qnhuw08/test2/Module_Relay_RS485/Production/Schematic PDF/Module_Relay_RS485.pdf

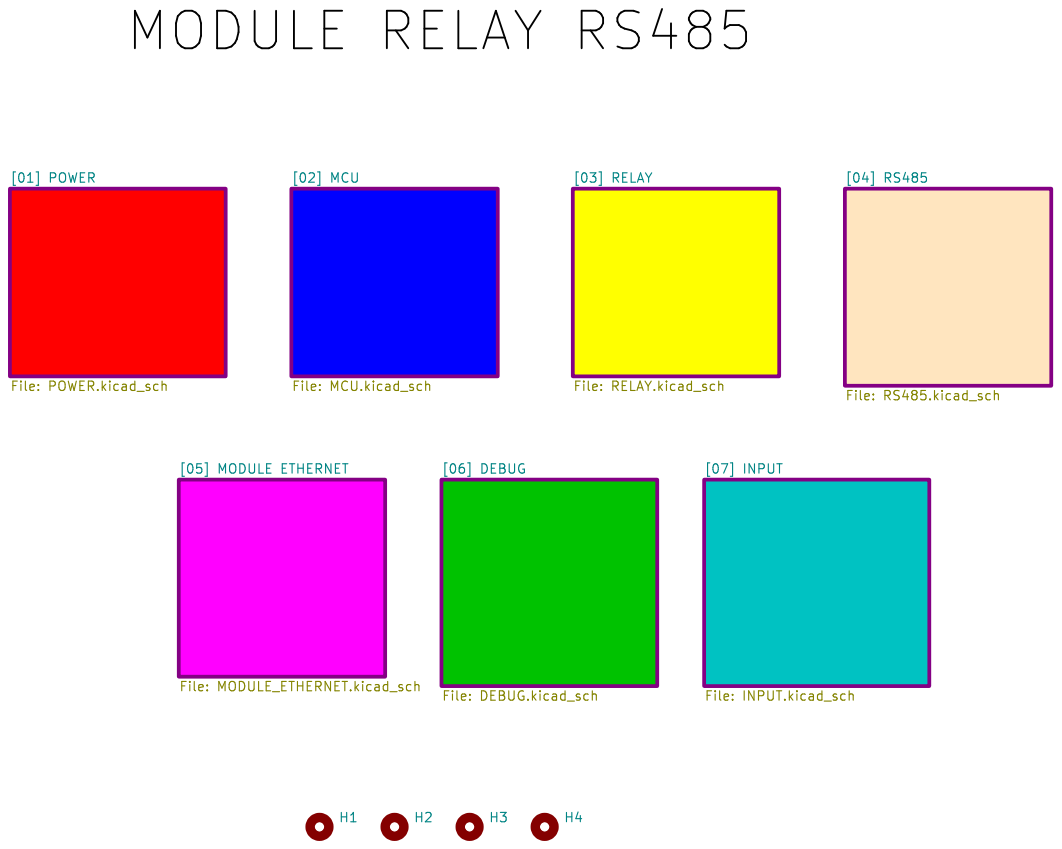
[picture p1: page 1]

Id: 1/8 Title: File: Module_Relay_RS485.kicad_sch Sheet: /

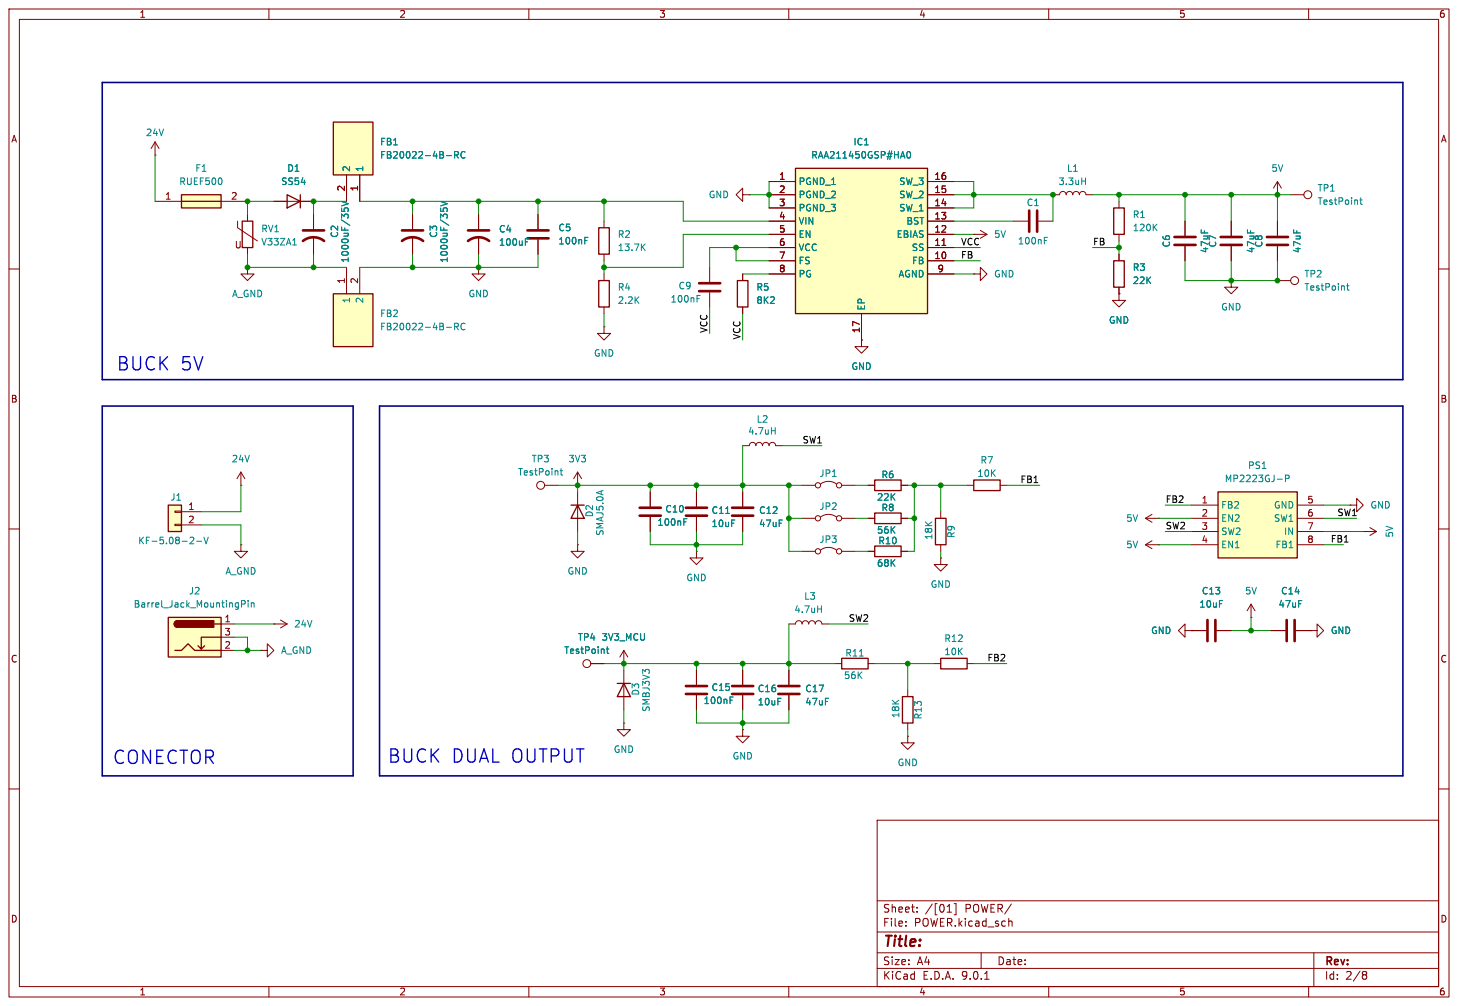
[picture p2: page 2]

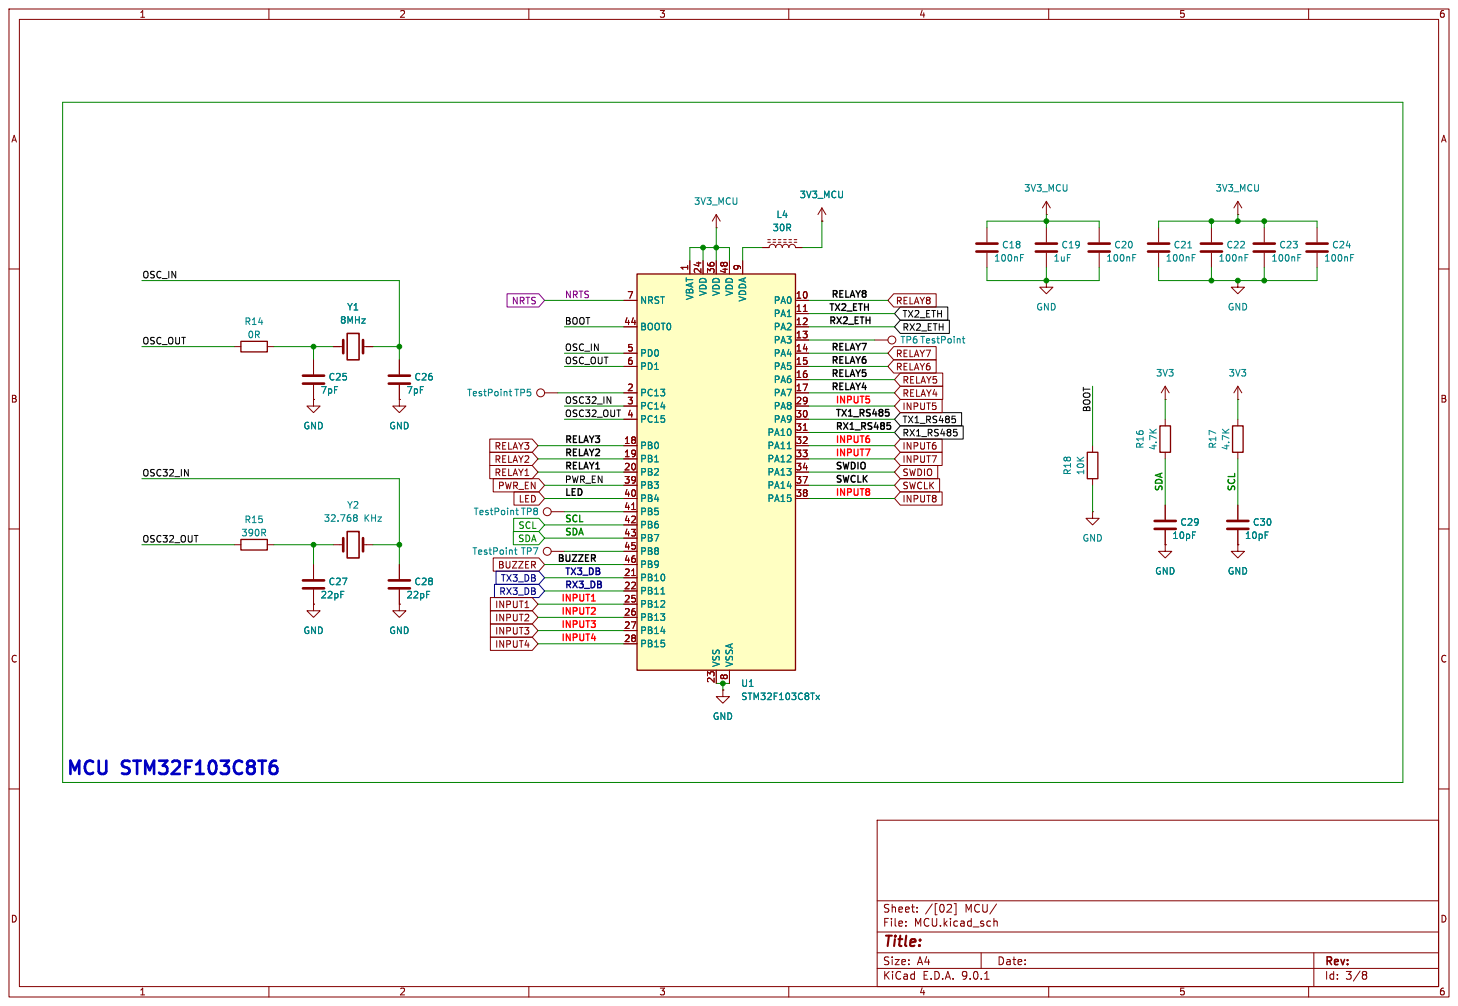
[picture p3: page 3]

1 VDD 24 VDD 36 VSS 23 VDD 48 VSSA

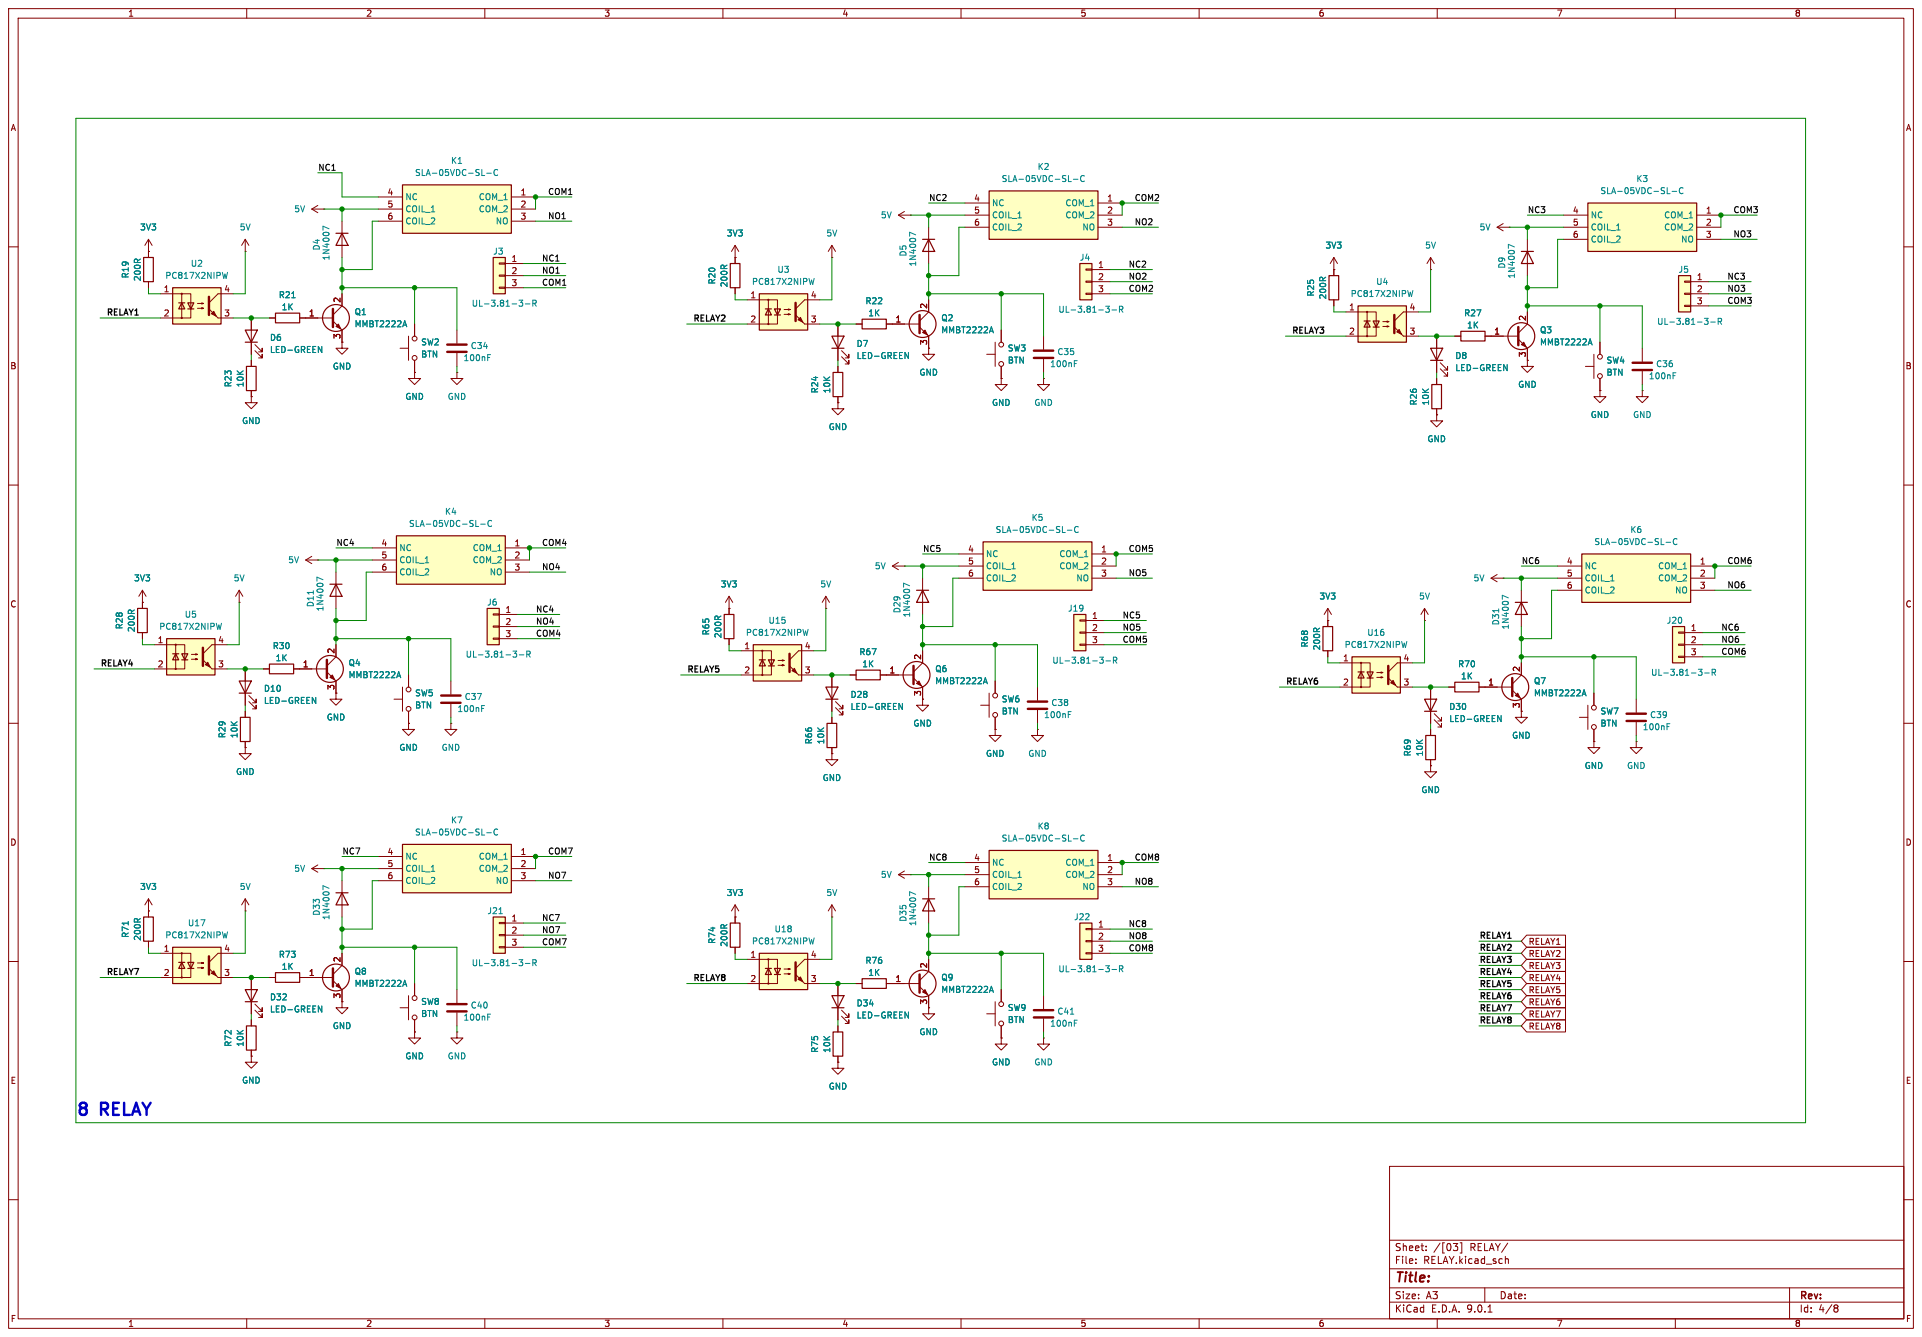
[picture p4: page 4]

2 3 Q2 MMBT2222A COM_1 1 COM_2 2 NO 3 NC 4 COIL_1 5 COIL_2 6 K5 SLA-05VDC-SL-C

2 3 Q8 MMBT2222A COM_1 1 COM_2 2 NO 3 NC 4 COIL_1 5 COIL_2 6 K7 SLA-05VDC-SL-C

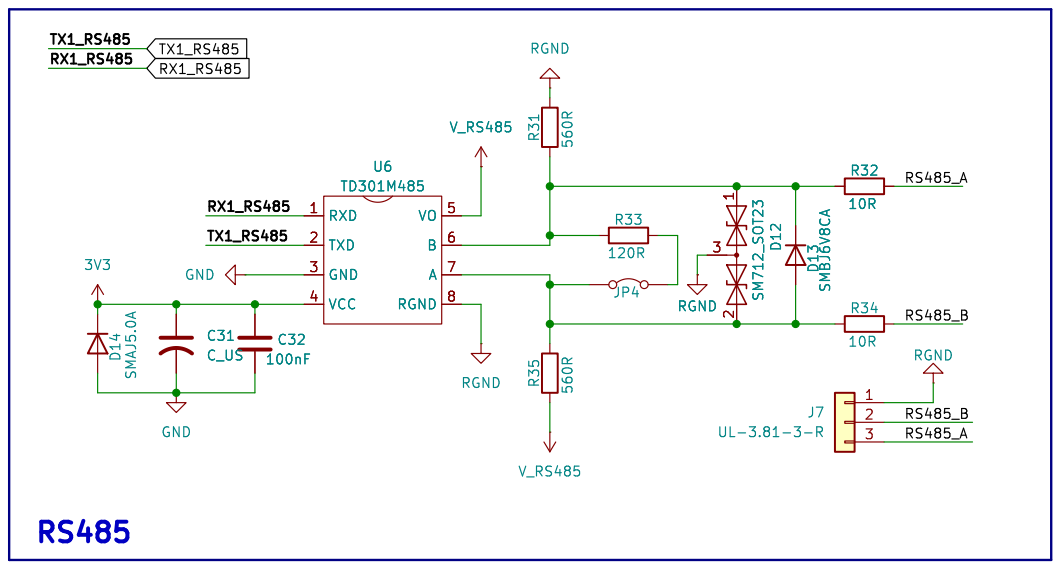
[picture p5: page 5]

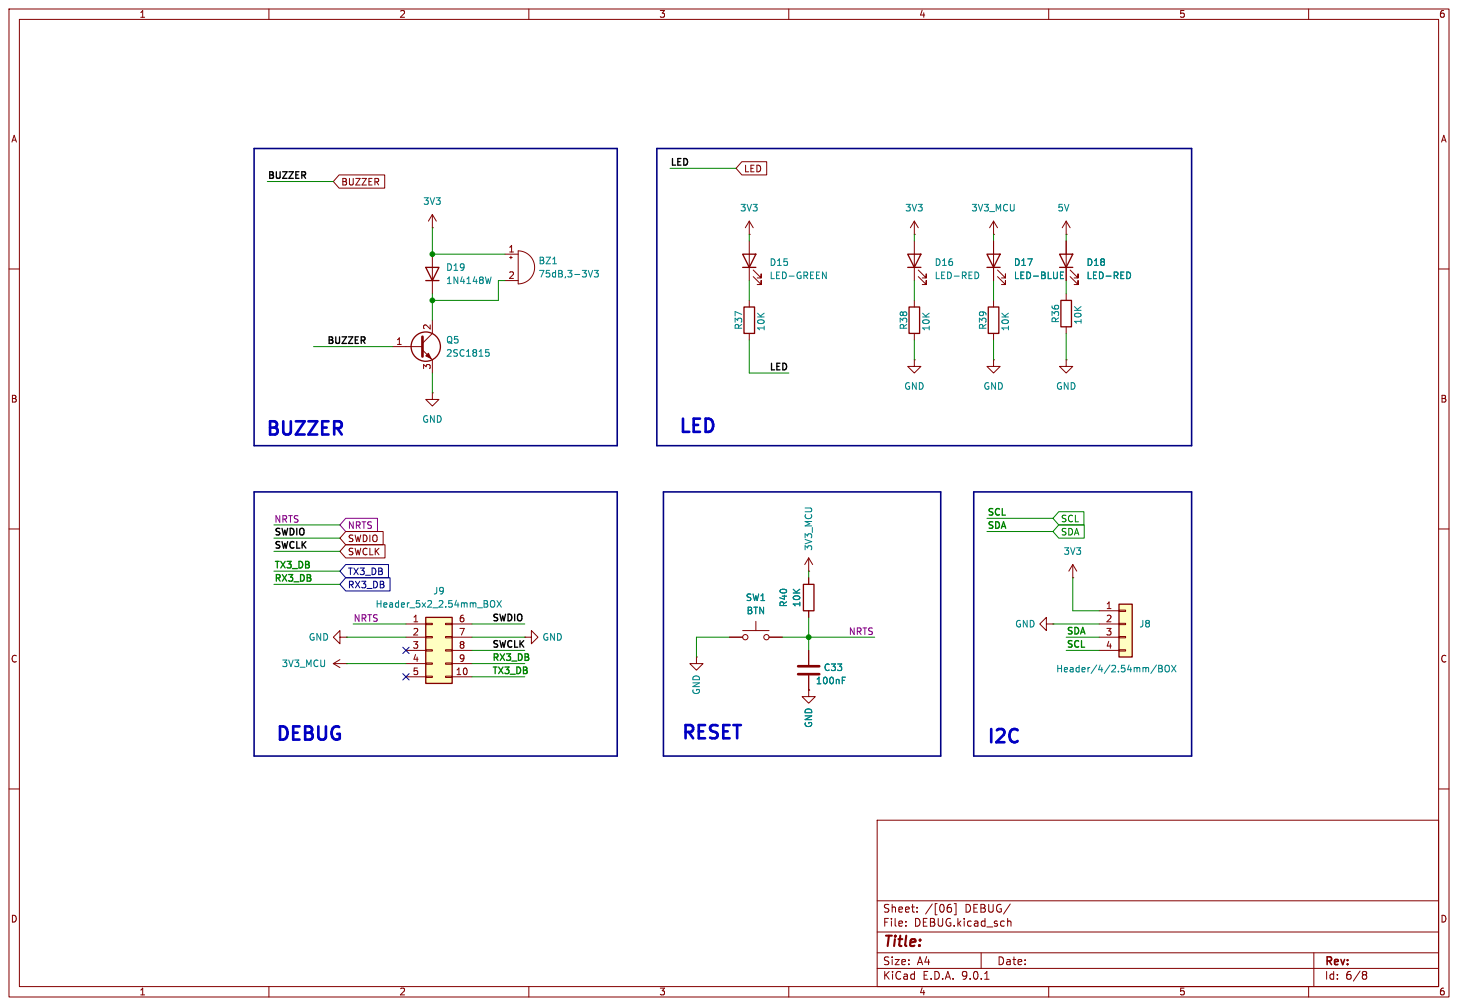
[picture p6: page 6]

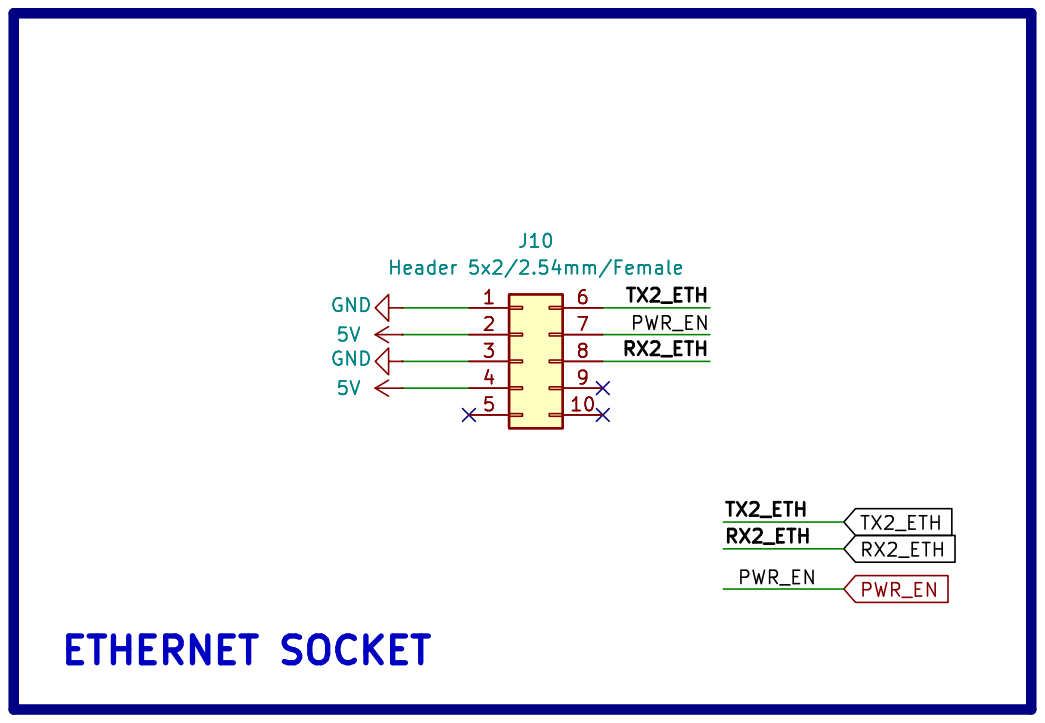
[picture p7: page 7]

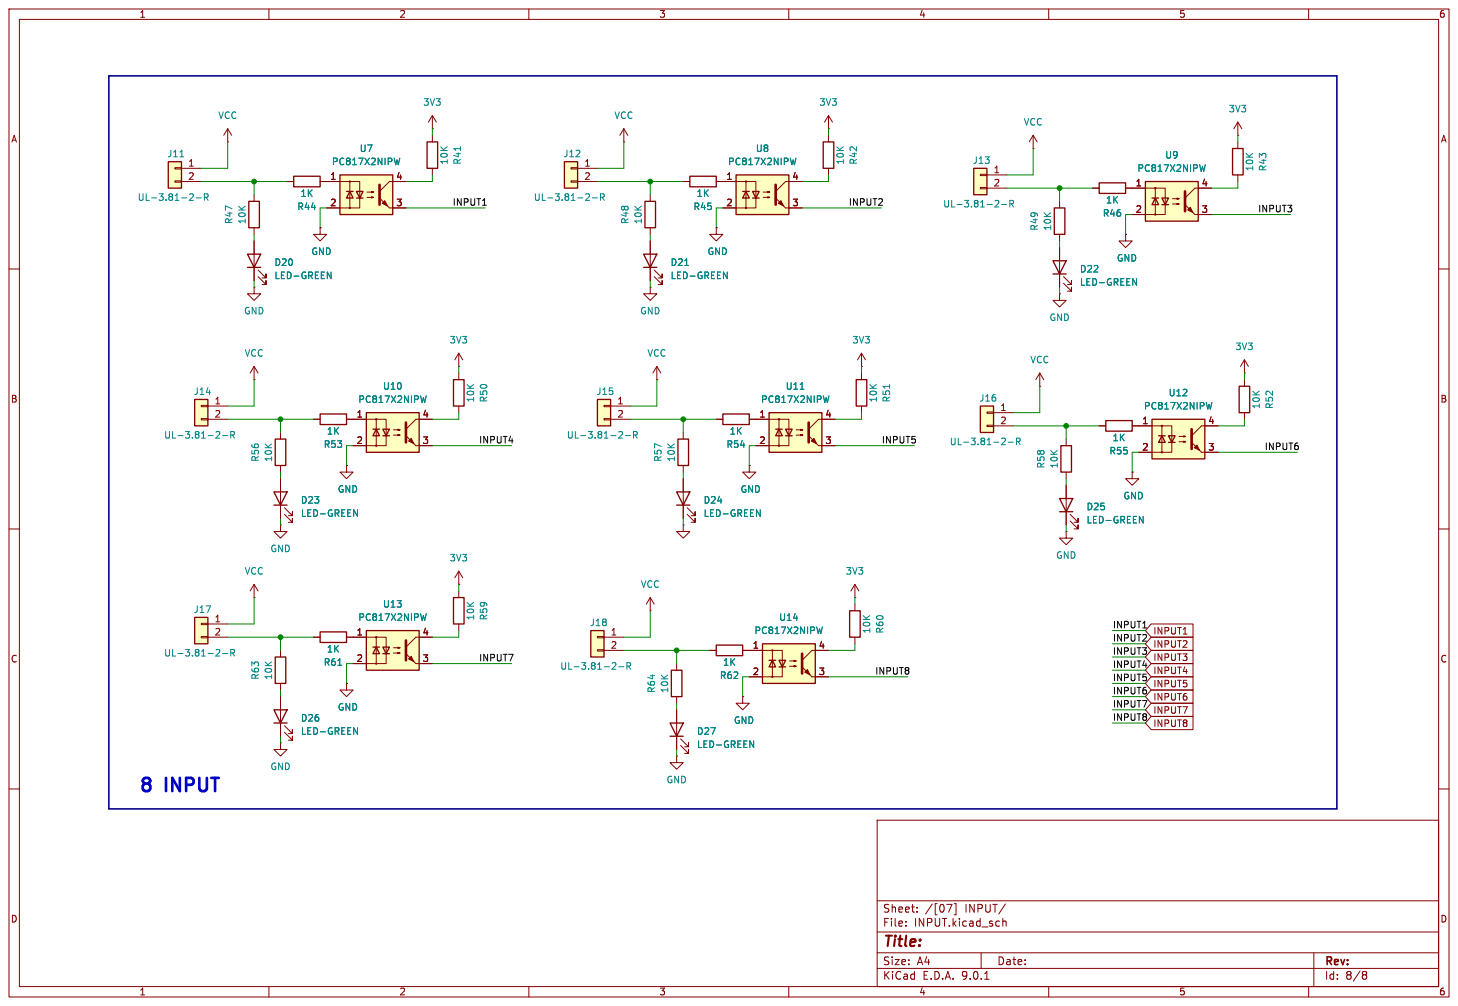
[picture p8: page 8]
