qnhuw08/test2/Module_Relay_RS485/Production/PCB PDF/Module_Relay_RS485-B_Cu.pdf

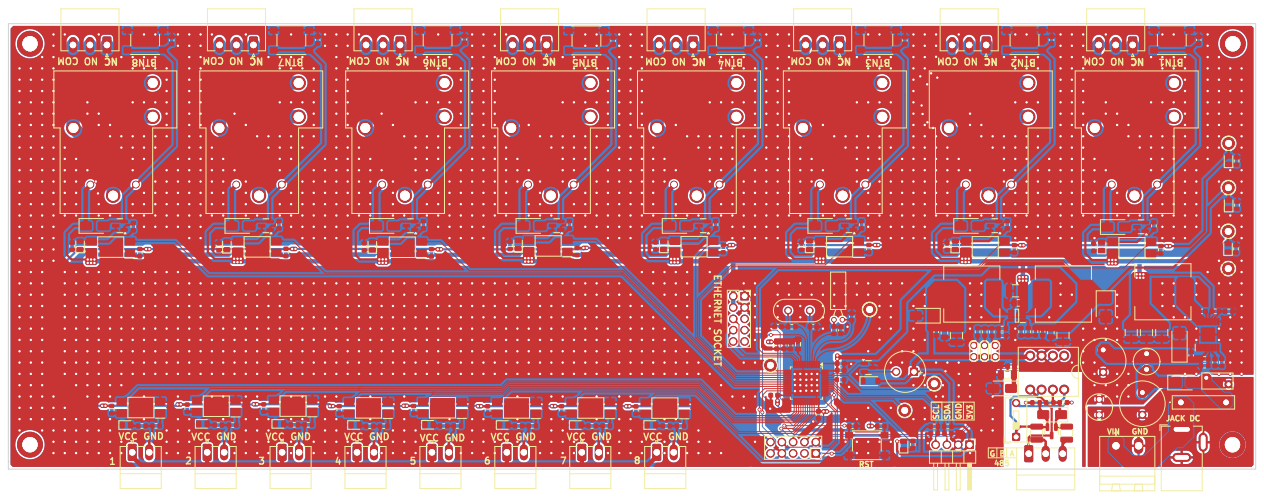
[picture p9: page 1]
