qnhuw08/test2/Module_Relay_RS485/Production/PCB PDF/Module_Relay_RS485-B_Silkscreen.pdf

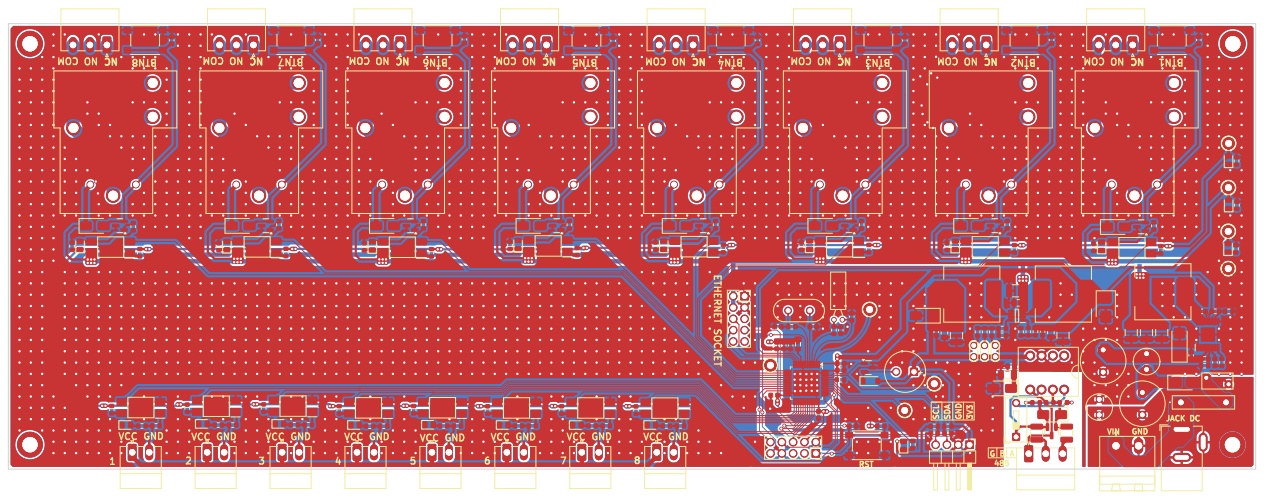
[picture p10: page 1]
