qnhuw08/test2/Module_Relay_RS485/Production/PCB PDF/Module_Relay_RS485-Edge_Cuts.pdf

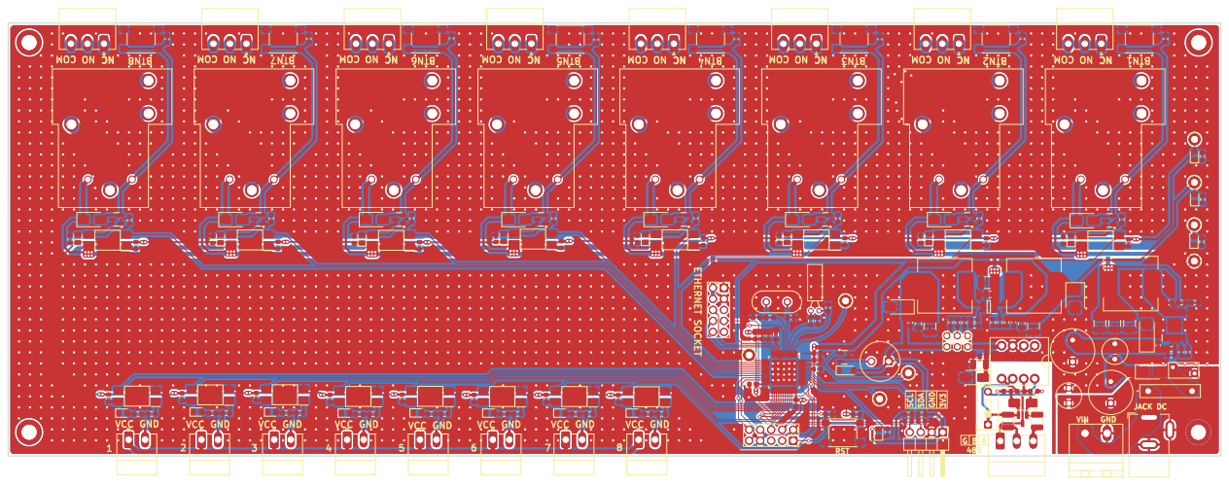
[picture p11: page 1]
