qnhuw08/test2/Module_Relay_RS485/Production/PCB PDF/Module_Relay_RS485-F_Cu.pdf

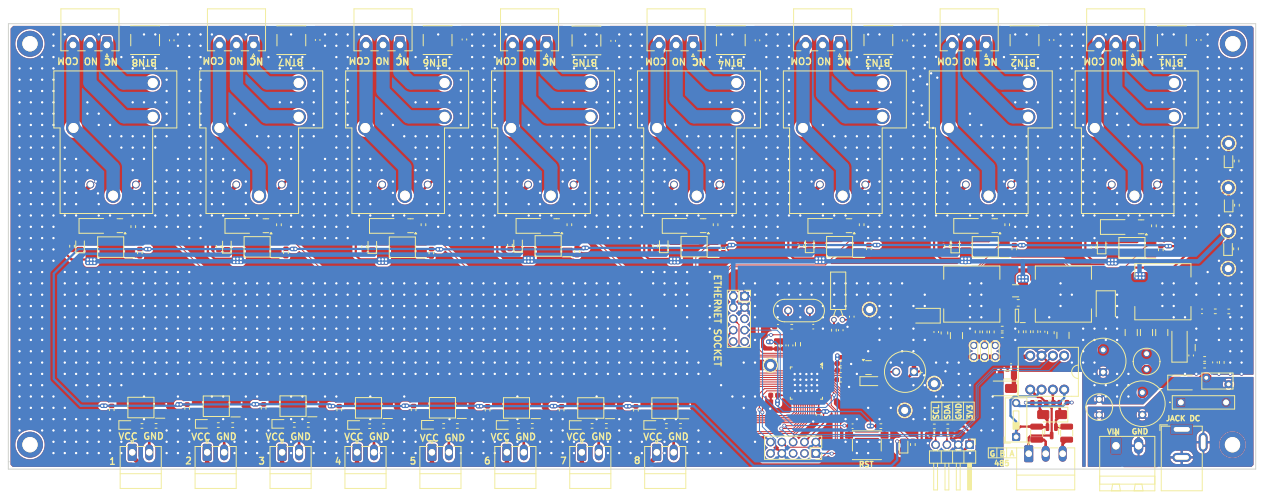
[picture p12: page 1]
