qnhuw08/test2/Module_Relay_RS485/Production/PCB PDF/Module_Relay_RS485-F_Silkscreen.pdf

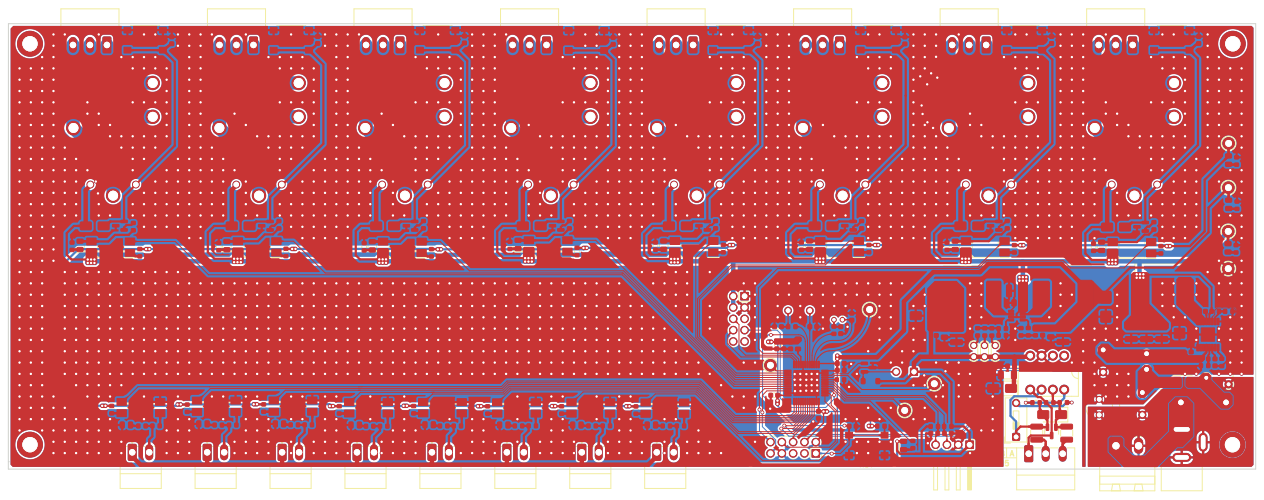
[picture p13: page 1]
