qnhuw08/test2/Module_Relay_RS485/Module_Relay_RS485.kicad_pcb

## KiCad design Module_Relay_RS485/Module_Relay_RS485.kicad_pcb (2026-03-02)

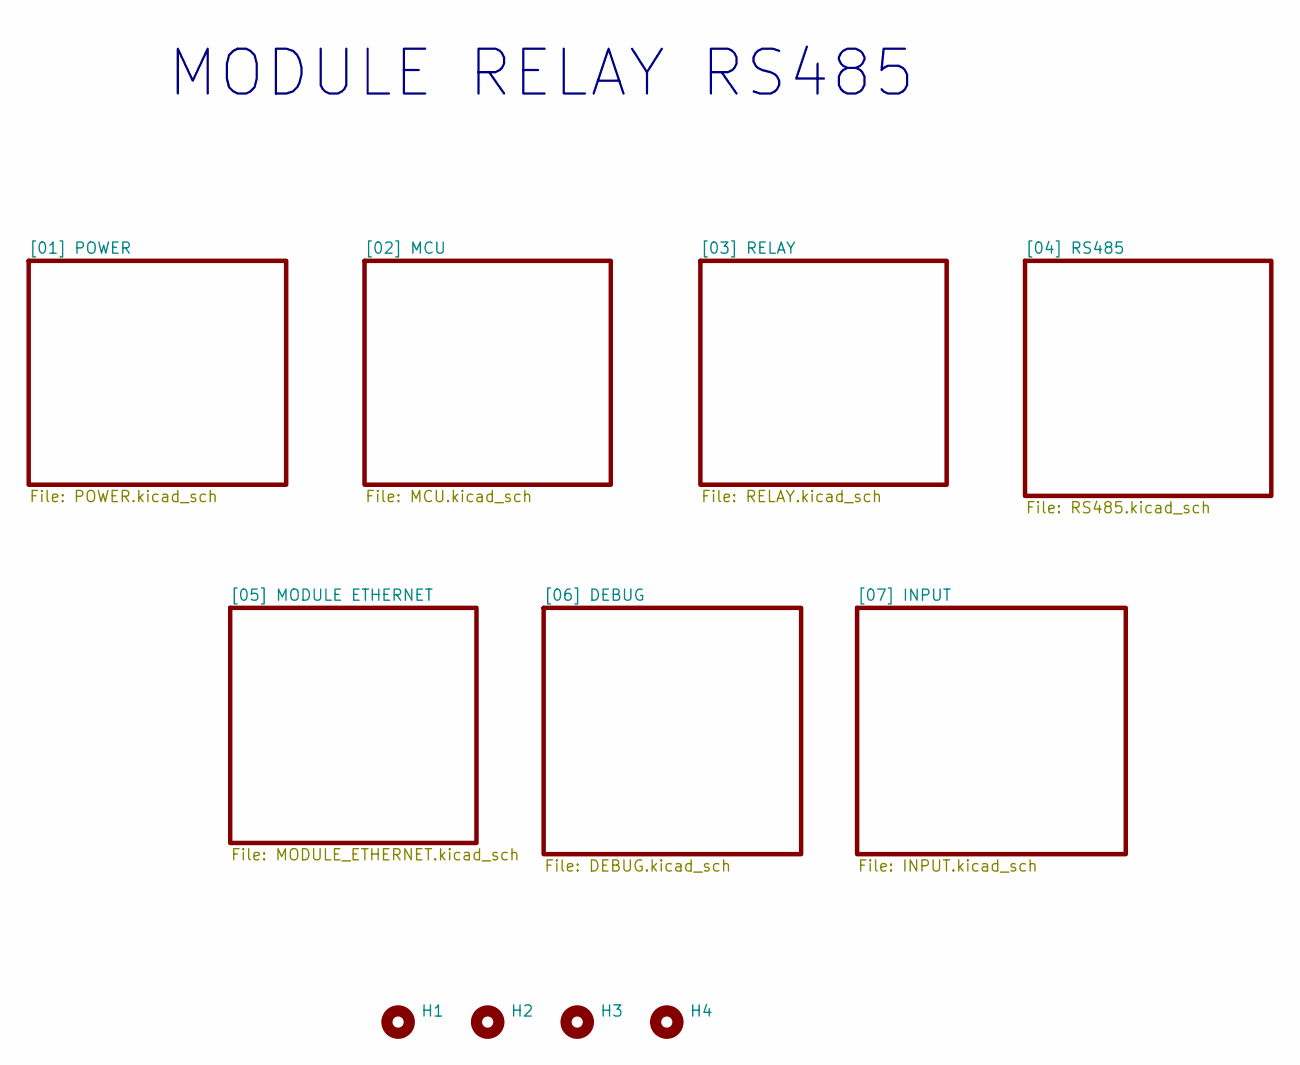
[picture p14: schematic Module_Relay_RS485.kicad_sch]

Parts:
H1, H2, H3, H4: MountingHole; MountingHole_3.2mm_M3_DIN965_Pad

Notes on the sheet:
MODULE RELAY RS485

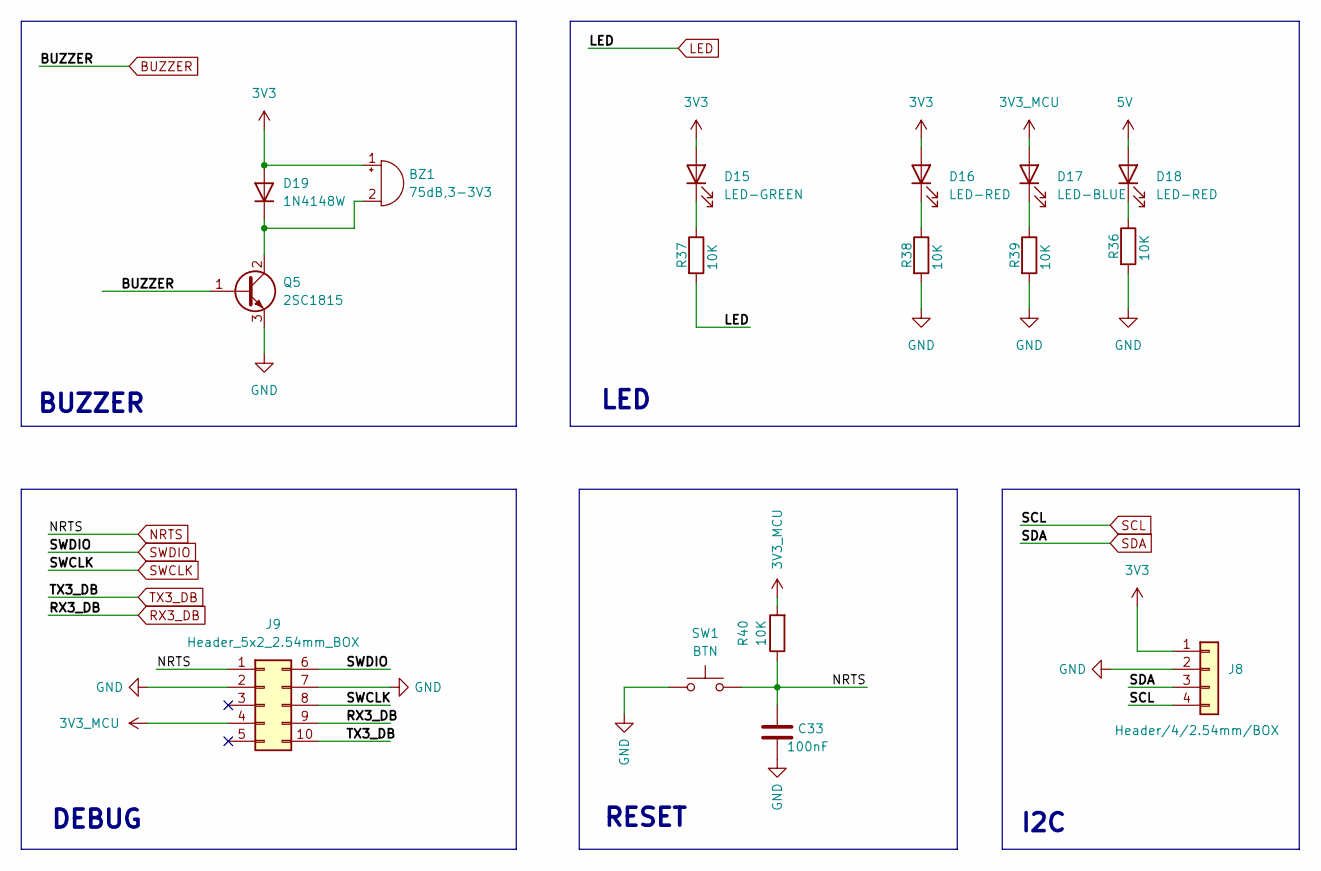
[picture p15: schematic DEBUG.kicad_sch]

Parts:
BZ1: 75dB,3-3V3; MagneticBuzzer_PUI_AT-0927-TT-6-R
C33: 100nF; C_0603_1608Metric
D15: LED-GREEN; LED_0805_2012Metric
D16, D18: LED-RED; LED_0805_2012Metric
D17: LED-BLUE; LED_0805_2012Metric
D19: 1N4148W; D_SOD-123
J8: Header/4/2.54mm/BOX; PinHeader_1x04_P2.54mm_Horizontal
J9: Header_5x2_2.54mm_BOX; Header_2x5_2.54mm_BOX
Q5: 2SC1815; SOT-23
R36, R37, R38, R39, R40: 10K; R_0603_1608Metric
SW1: BTN; SW_SPST_PTS645

Connections:
3V3: BZ1.1 (+), D15.2 (A), D16.2 (A), D19.2 (A), J8.1; also elsewhere on the board
3V3_MCU: D17.2 (A), J9.4, R40.2; also elsewhere on the board
5V: D18.2 (A); also elsewhere on the board
BUZZER: Q5.1 (B); also elsewhere on the board
GND: C33.2, J8.2, J9.2, J9.7, Q5.3 (E), R36.2, R38.2, R39.2, SW1.1; also elsewhere on the board
LED: R37.2; also elsewhere on the board
NRTS: C33.1, J9.1, R40.1, SW1.2; also elsewhere on the board
unnamed: BZ1.2 (-), D19.1 (K), Q5.2 (C)
unnamed: D15.1 (K), R37.1
unnamed: D16.1 (K), R38.1
unnamed: D17.1 (K), R39.1
unnamed: D18.1 (K), R36.1
RX3_DB: J9.9; also elsewhere on the board
SCL: J8.4; also elsewhere on the board
SDA: J8.3; also elsewhere on the board
SWCLK: J9.8; also elsewhere on the board
SWDIO: J9.6; also elsewhere on the board
TX3_DB: J9.10; also elsewhere on the board

Notes on the sheet:
I2C
LED
BUZZER
DEBUG
RESET

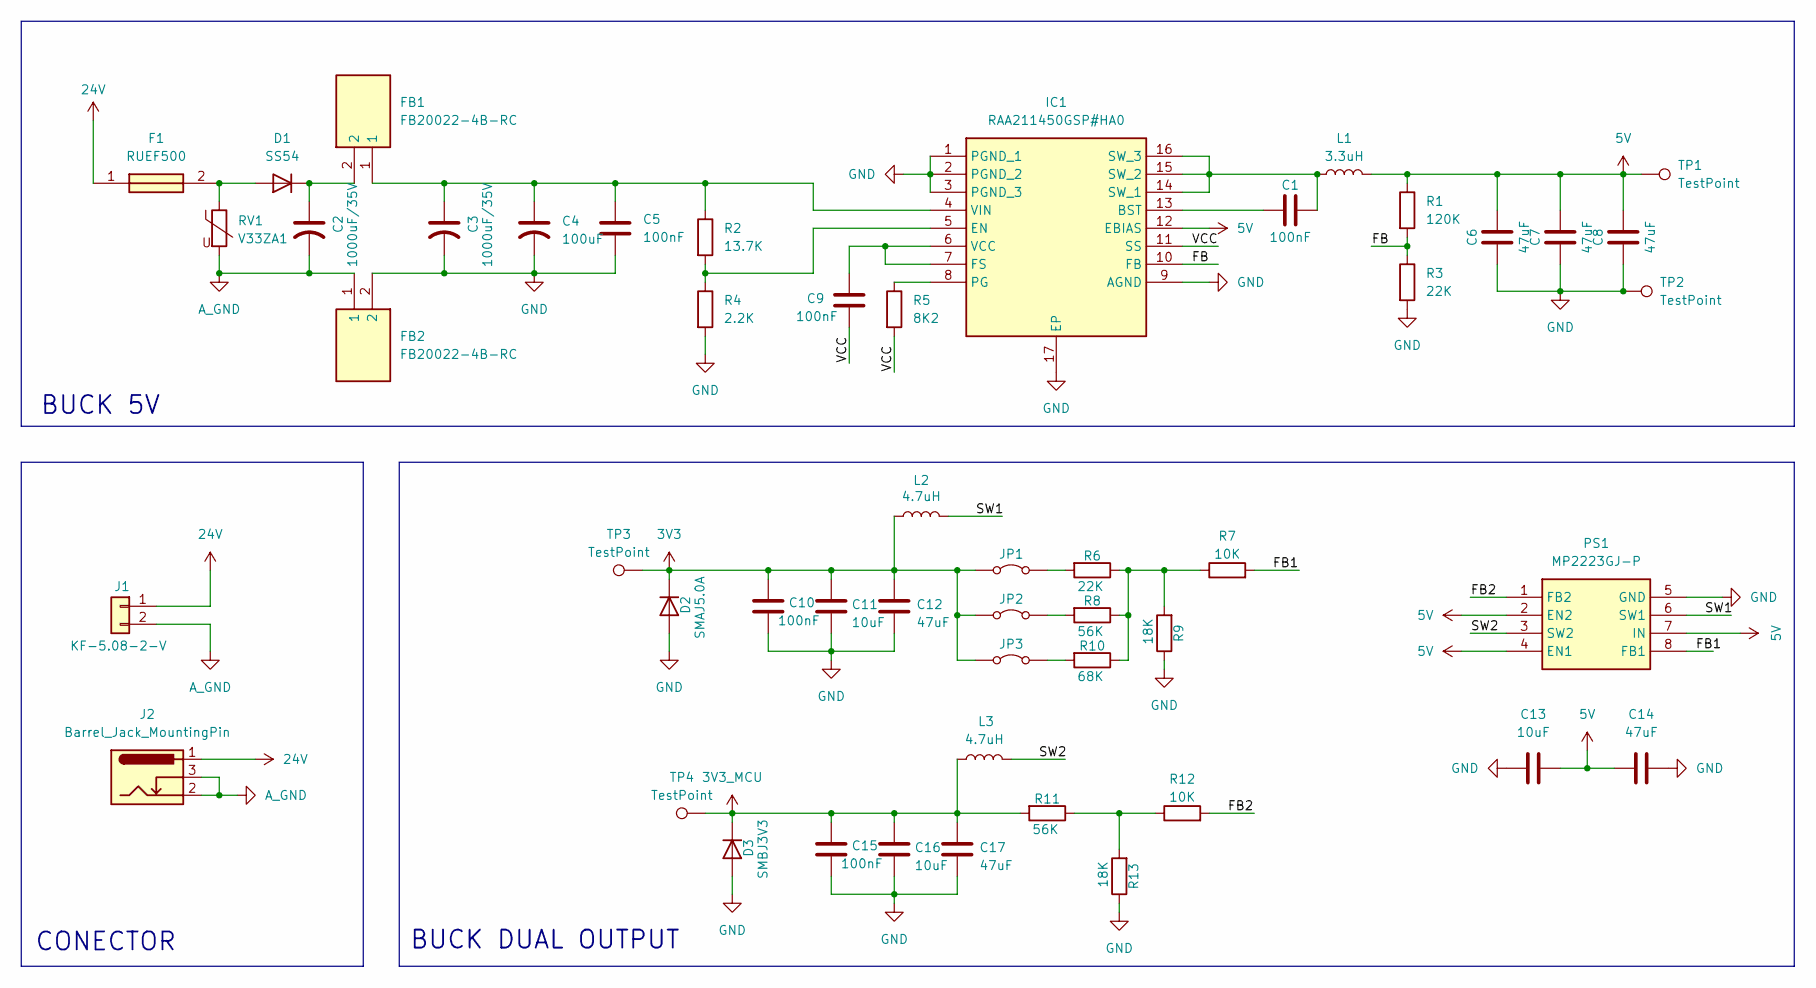
[picture p16: schematic POWER.kicad_sch]

Parts:
C1, C5, C9, C10, C15: 100nF; C_0603_1608Metric
C2, C3: 1000uF/35V; C_Radial_D10.0mm_H20.0mm_P5.00mm
C4: 100uF; CP_EIA-6032-15_Kemet-U_HandSolder
C6, C7, C8, C12, C14, C17: 47uF; C_1210_3225Metric
C11, C13, C16: 10uF; C_0805_2012Metric
D1: SS54; D_SMA
D2: SMAJ5.0A; D_SMA
D3: SMBJ3V3; D_SMB
F1: RUEF500; Manufacturer_Part_Number RUEF500
FB1, FB2: FB20022-4B-RC; FB200224BRC; Manufacturer_Part_Number FB20022-4B-RC; Mouser Part Number 542-FB20022-4B-RC
IC1: RAA211450GSP#HA0; SOP65P640X120-17N; Manufacturer_Part_Number RAA211450GSP#HA0; Mouser Part Number 968-RAA211450GSP#HA0
J1: KF-5.08-2-V; PhoenixContact_MSTBA_2,5_2-G-5,08_1x02_P5.08mm_Horizontal
J2: Barrel_Jack_MountingPin; BarrelJack_GCT_DCJ200-10-A_Horizontal
JP1, JP2, JP3: Jumper_2_Bridged; TestPoint_2Pads_Pitch2.54mm_Drill0.8mm
L1: 3.3uH; L_12x12mm_H8mm
L2, L3: 4.7uH; L_12x12mm_H8mm
PS1: MP2223GJ-P; SOT65P280X100-8N; Manufacturer_Part_Number MP2223GJ-P; Mouser Part Number 946-MP2223GJ-P
R1: 120K; R_0603_1608Metric
R2: 13.7K; R_0603_1608Metric
R3, R6: 22K; R_0603_1608Metric
R4: 2.2K; R_0603_1608Metric
R5: 8K2; R_0603_1608Metric
R7, R12: 10K; R_0603_1608Metric
R8, R11: 56K; R_0603_1608Metric
R9, R13: 18K; R_0603_1608Metric
R10: 68K; R_0603_1608Metric
RV1: V33ZA1; RV_Disc_D7mm_W3.6mm_P5mm
TP1, TP2, TP3, TP4: TestPoint; Pin_D1.3mm_L11.0mm

Connections:
3V3: C10.1, C11.1, C12.1, D2.1 (K), JP1.1 (A), JP2.1 (A), JP3.1 (A), L2.1, TP3.1; also elsewhere on the board
3V3_MCU: C15.1, C16.1, C17.1, D3.1 (K), L3.1, R11.2, TP4.1; also elsewhere on the board
5V: C6.2, C7.2, C8.2, C13.2, C14.1, IC1.12 (EBIAS), L1.2, PS1.2 (EN2), PS1.4 (EN1), PS1.7 (IN), R1.1, TP1.1; also elsewhere on the board
24V: F1.1, J1.1, J2.1
/[01] POWER/FB1: PS1.8 (FB1), R7.2
/[01] POWER/FB2: PS1.1 (FB2), R12.2
/[01] POWER/FB: IC1.10 (FB), R1.2, R3.1
/[01] POWER/SW1: L2.2, PS1.6 (SW1)
/[01] POWER/SW2: L3.2, PS1.3 (SW2)
/[01] POWER/VCC: C9.2, IC1.11 (SS), R5.2
A_GND: C2.2, FB2.1, J1.2, J2.2, J2.3, RV1.2
GND: C3.2, C4.2, C5.2, C6.1, C7.1, C8.1, C10.2, C11.2, C12.2, C13.1, C14.2, C15.2, C16.2, C17.2, D2.2 (A), D3.2 (A), FB2.2, IC1.1 (PGND_1), IC1.2 (PGND_2), IC1.3 (PGND_3), IC1.9 (AGND), IC1.17 (EP), PS1.5 (GND), R3.2, R4.2, R9.1, R13.1, TP2.1; also elsewhere on the board
unnamed: D1.2 (A), F1.2, RV1.1
unnamed: C2.1, D1.1 (K), FB1.2
unnamed: C1.1, IC1.13 (BST)
unnamed: IC1.5 (EN), R2.2, R4.1
unnamed: C9.1, IC1.6 (VCC), IC1.7 (FS)
unnamed: IC1.8 (PG), R5.1
unnamed: C1.2, IC1.14 (SW_1), IC1.15 (SW_2), IC1.16 (SW_3), L1.1
unnamed: C3.1, C4.1, C5.1, FB1.1, IC1.4 (VIN), R2.1
unnamed: JP1.2 (B), R6.2
unnamed: JP2.2 (B), R8.2
unnamed: JP3.2 (B), R10.2
unnamed: R6.1, R7.1, R8.1, R9.2, R10.1
unnamed: R11.1, R12.1, R13.2

Notes on the sheet:
BUCK 5V
CONECTOR
BUCK DUAL OUTPUT

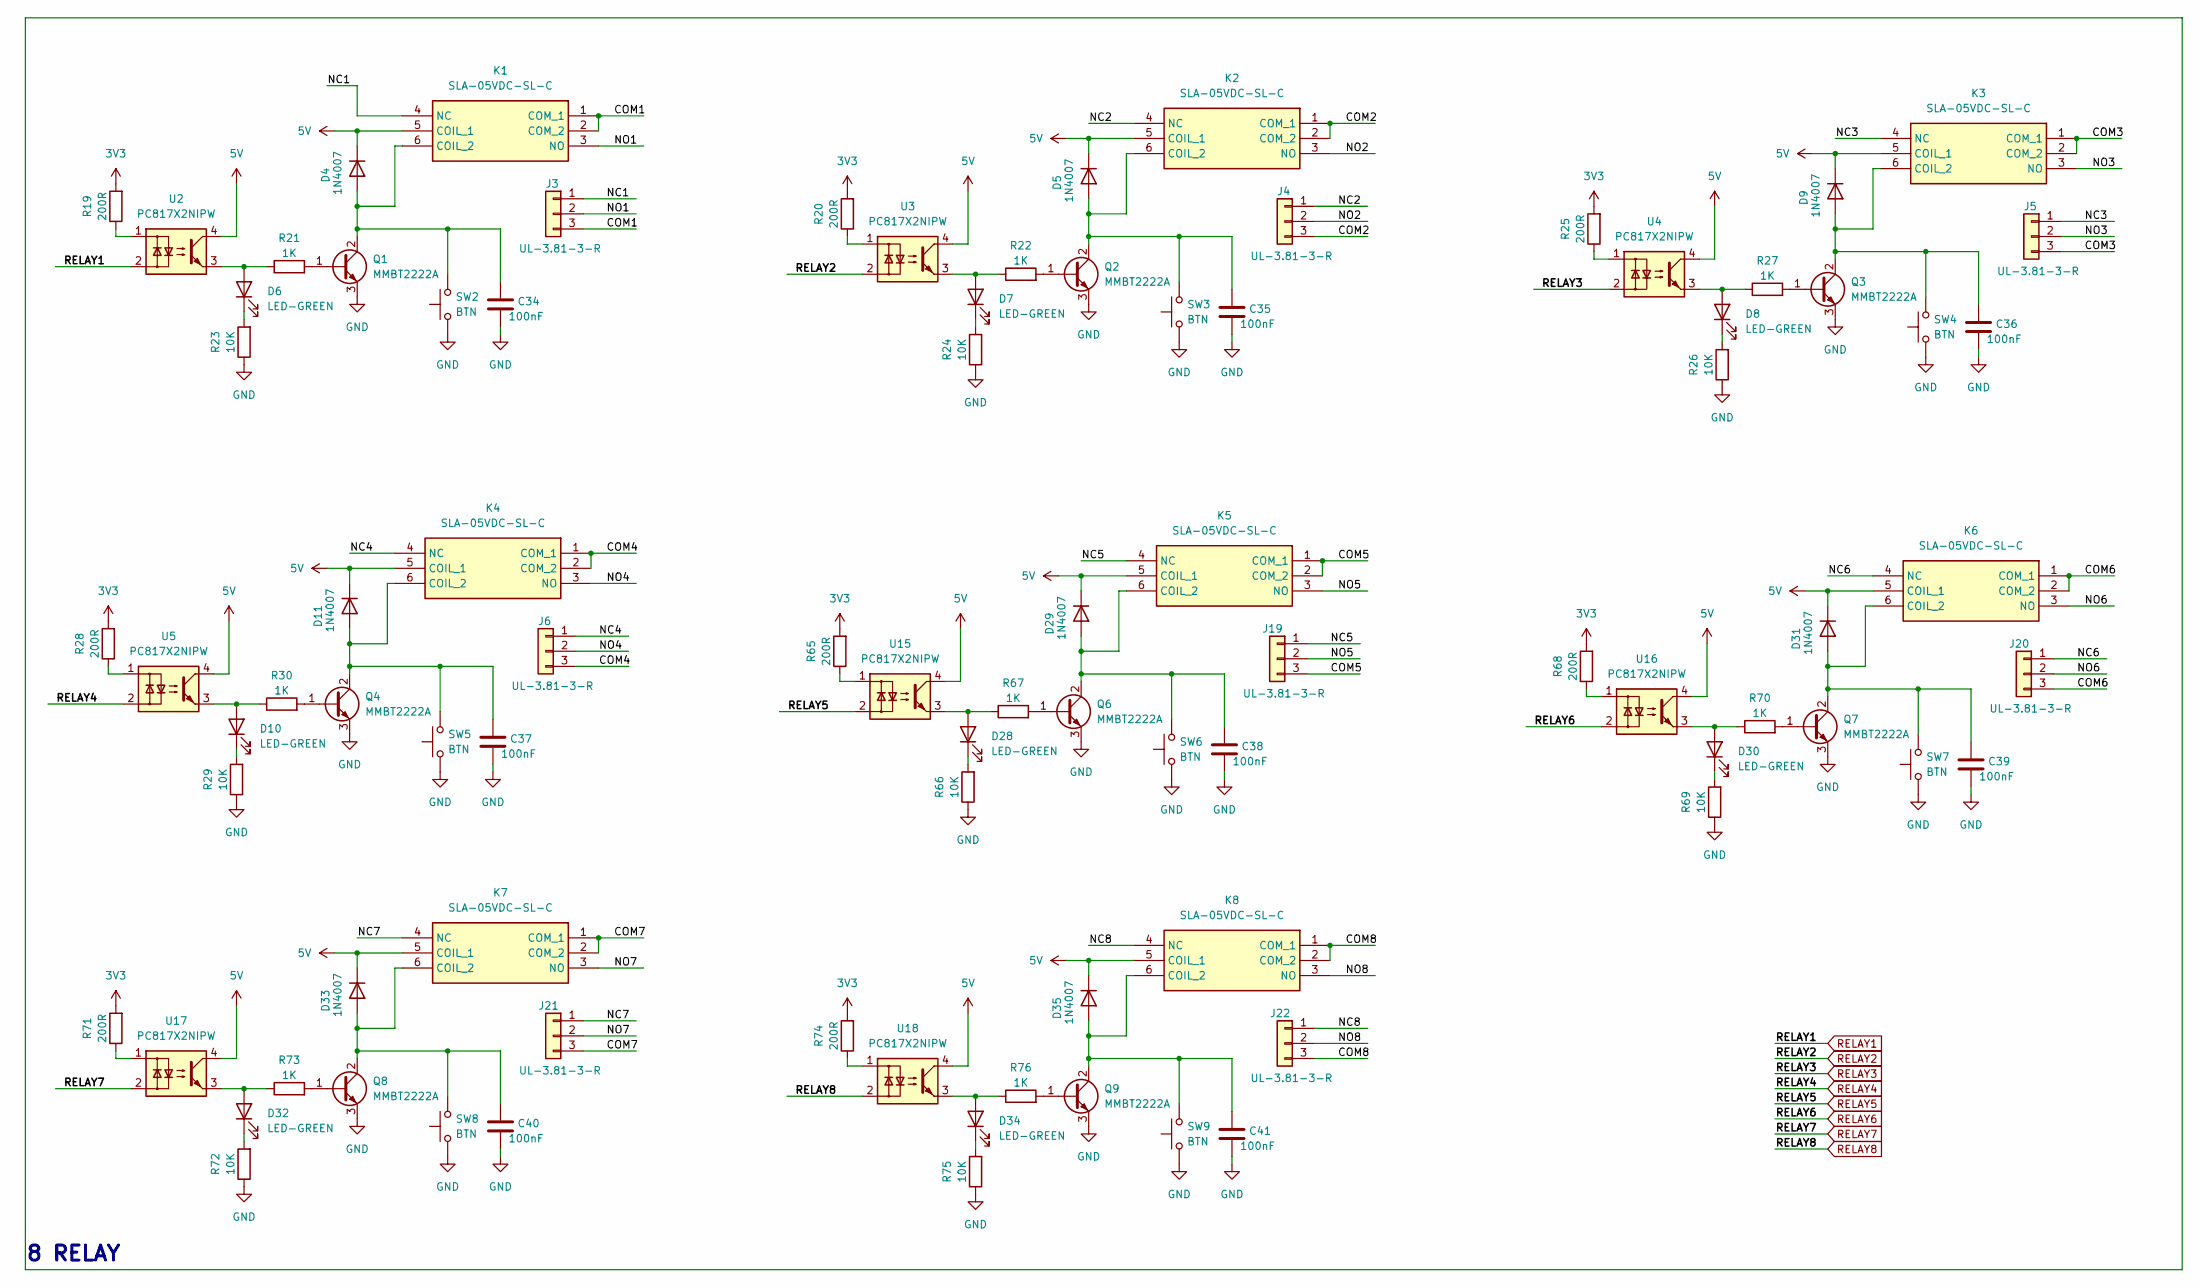
[picture p17: schematic RELAY.kicad_sch]

Parts:
C34, C35, C36, C37, C38, C39, C40, C41: 100nF; C_0603_1608Metric
D4, D5, D9, D11, D29, D31, D33, D35: 1N4007; D_SMA
D6, D7, D8, D10, D28, D30, D32, D34: LED-GREEN; LED_0805_2012Metric
J3, J4, J5, J6, J19, J20, J21, J22: UL-3.81-3-R; PhoenixContact_MC_1,5_3-G-3.81_1x03_P3.81mm_Horizontal
K1, K2, K3, K4, K5, K6, K7, K8: SLA-05VDC-SL-C; SLA05VDCSLC; Manufacturer_Part_Number SLA-05VDC-SL-C
Q1, Q2, Q3, Q4, Q6, Q7, Q8, Q9: MMBT2222A; SOT-23
R19, R20, R25, R28, R65, R68, R71, R74: 200R; R_0603_1608Metric
R21, R22, R27, R30, R67, R70, R73, R76: 1K; R_0603_1608Metric
R23, R24, R26, R29, R66, R69, R72, R75: 10K; R_0603_1608Metric
SW2, SW3, SW4, SW5, SW6, SW7, SW8, SW9: BTN; SW_SPST_PTS645
U2, U3, U4, U5, U15, U16, U17, U18: PC817X2NIPW; SOP254P960X380-4N

Connections:
3V3: R19.2, R20.2, R25.2, R28.2, R65.2, R68.2, R71.2, R74.2; also elsewhere on the board
5V: D4.1 (K), D5.1 (K), D9.1 (K), D11.1 (K), D29.1 (K), D31.1 (K), D33.1 (K), D35.1 (K), K1.5 (COIL_1), K2.5 (COIL_1), K3.5 (COIL_1), K4.5 (COIL_1), K5.5 (COIL_1), K6.5 (COIL_1), K7.5 (COIL_1), K8.5 (COIL_1), U2.4, U3.4, U4.4, U5.4, U15.4, U16.4, U17.4, U18.4; also elsewhere on the board
/[03] RELAY/COM1: J3.3, K1.1 (COM_1), K1.2 (COM_2)
/[03] RELAY/COM2: J4.3, K2.1 (COM_1), K2.2 (COM_2)
/[03] RELAY/COM3: J5.3, K3.1 (COM_1), K3.2 (COM_2)
/[03] RELAY/COM4: J6.3, K4.1 (COM_1), K4.2 (COM_2)
/[03] RELAY/COM5: J19.3, K5.1 (COM_1), K5.2 (COM_2)
/[03] RELAY/COM6: J20.3, K6.1 (COM_1), K6.2 (COM_2)
/[03] RELAY/COM7: J21.3, K7.1 (COM_1), K7.2 (COM_2)
/[03] RELAY/COM8: J22.3, K8.1 (COM_1), K8.2 (COM_2)
/[03] RELAY/NC1: J3.1, K1.4 (NC)
/[03] RELAY/NC2: J4.1, K2.4 (NC)
/[03] RELAY/NC3: J5.1, K3.4 (NC)
/[03] RELAY/NC4: J6.1, K4.4 (NC)
/[03] RELAY/NC5: J19.1, K5.4 (NC)
/[03] RELAY/NC6: J20.1, K6.4 (NC)
/[03] RELAY/NC7: J21.1, K7.4 (NC)
/[03] RELAY/NC8: J22.1, K8.4 (NC)
/[03] RELAY/NO1: J3.2, K1.3 (NO)
/[03] RELAY/NO2: J4.2, K2.3 (NO)
/[03] RELAY/NO3: J5.2, K3.3 (NO)
/[03] RELAY/NO4: J6.2, K4.3 (NO)
/[03] RELAY/NO5: J19.2, K5.3 (NO)
/[03] RELAY/NO6: J20.2, K6.3 (NO)
/[03] RELAY/NO7: J21.2, K7.3 (NO)
/[03] RELAY/NO8: J22.2, K8.3 (NO)
GND: C34.2, C35.2, C36.2, C37.2, C38.2, C39.2, C40.2, C41.2, Q1.3 (E), Q2.3 (E), Q3.3 (E), Q4.3 (E), Q6.3 (E), Q7.3 (E), Q8.3 (E), Q9.3 (E), R23.1, R24.1, R26.1, R29.1, R66.1, R69.1, R72.1, R75.1, SW2.1, SW3.1, SW4.1, SW5.1, SW6.1, SW7.1, SW8.1, SW9.1; also elsewhere on the board
unnamed: C34.1, D4.2 (A), K1.6 (COIL_2), Q1.2 (C), SW2.2
unnamed: C35.1, D5.2 (A), K2.6 (COIL_2), Q2.2 (C), SW3.2
unnamed: D6.2 (A), R21.1, U2.3
unnamed: D6.1 (K), R23.2
unnamed: D7.2 (A), R22.1, U3.3
unnamed: D7.1 (K), R24.2
unnamed: D8.2 (A), R27.1, U4.3
unnamed: D8.1 (K), R26.2
unnamed: C36.1, D9.2 (A), K3.6 (COIL_2), Q3.2 (C), SW4.2
unnamed: D10.2 (A), R30.1, U5.3
unnamed: D10.1 (K), R29.2
unnamed: C37.1, D11.2 (A), K4.6 (COIL_2), Q4.2 (C), SW5.2
unnamed: D28.2 (A), R67.1, U15.3
unnamed: D28.1 (K), R66.2
unnamed: C38.1, D29.2 (A), K5.6 (COIL_2), Q6.2 (C), SW6.2
unnamed: D30.2 (A), R70.1, U16.3
unnamed: D30.1 (K), R69.2
unnamed: C39.1, D31.2 (A), K6.6 (COIL_2), Q7.2 (C), SW7.2
unnamed: D32.2 (A), R73.1, U17.3
unnamed: D32.1 (K), R72.2
unnamed: C40.1, D33.2 (A), K7.6 (COIL_2), Q8.2 (C), SW8.2
unnamed: D34.2 (A), R76.1, U18.3
unnamed: D34.1 (K), R75.2
unnamed: C41.1, D35.2 (A), K8.6 (COIL_2), Q9.2 (C), SW9.2
unnamed: Q1.1 (B), R21.2
unnamed: Q2.1 (B), R22.2
unnamed: Q3.1 (B), R27.2
unnamed: Q4.1 (B), R30.2
unnamed: Q6.1 (B), R67.2
unnamed: Q7.1 (B), R70.2
unnamed: Q8.1 (B), R73.2
unnamed: Q9.1 (B), R76.2
unnamed: R19.1, U2.1
unnamed: R20.1, U3.1
unnamed: R25.1, U4.1
unnamed: R28.1, U5.1
unnamed: R65.1, U15.1
unnamed: R68.1, U16.1
unnamed: R71.1, U17.1
unnamed: R74.1, U18.1
RELAY1: U2.2; also elsewhere on the board
RELAY2: U3.2; also elsewhere on the board
RELAY3: U4.2; also elsewhere on the board
RELAY4: U5.2; also elsewhere on the board
RELAY5: U15.2; also elsewhere on the board
RELAY6: U16.2; also elsewhere on the board
RELAY7: U17.2; also elsewhere on the board
RELAY8: U18.2; also elsewhere on the board

Notes on the sheet:
8 RELAY

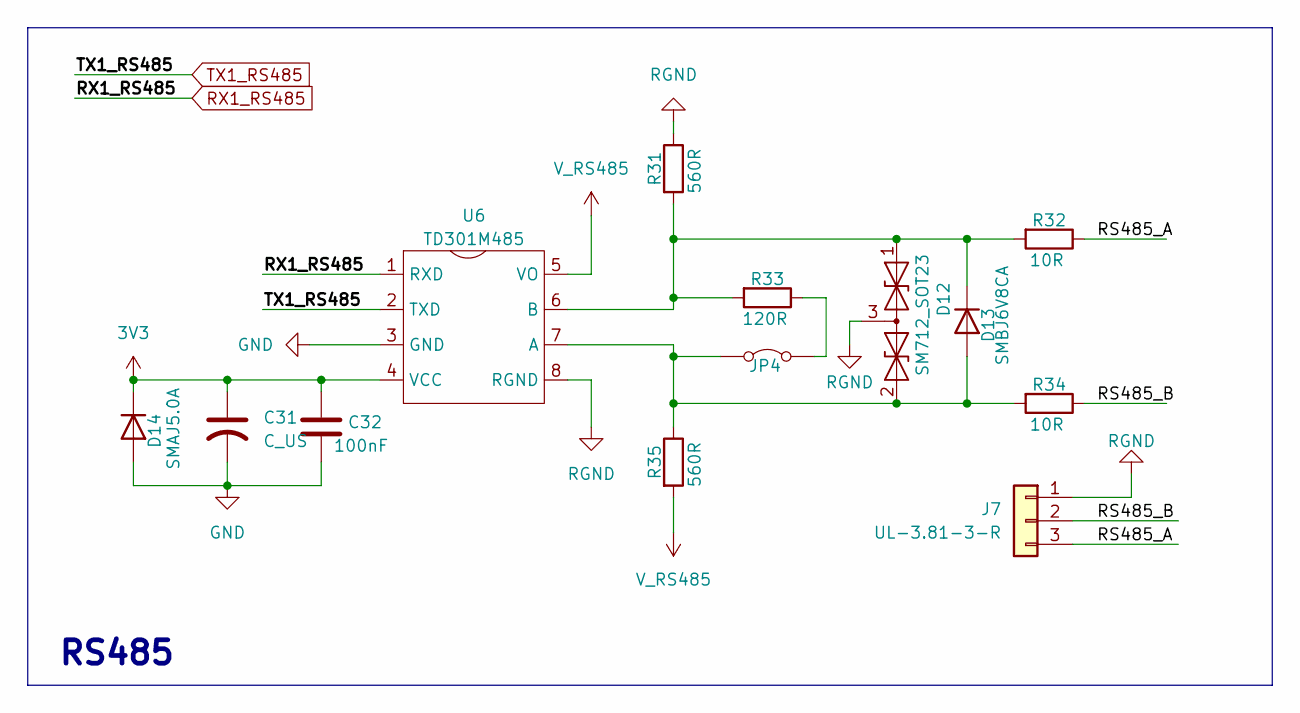
[picture p18: schematic RS485.kicad_sch]

Parts:
C31: C_US; C_1206_3216Metric
C32: 100nF; C_0603_1608Metric
D12: SM712_SOT23; SOT-23
D13: SMBJ6V8CA; D_SMA
D14: SMAJ5.0A; D_SMA
J7: UL-3.81-3-R; PhoenixContact_MC_1,5_3-G-3.81_1x03_P3.81mm_Horizontal
JP4: Jumper_2_Bridged; SW_DIP_SPSTx01_Slide_9.78x4.72mm_W7.62mm_P2.54mm
R31, R35: 560R; R_0603_1608Metric
R32, R34: 10R; R_1210_3225Metric
R33: 120R; R_0603_1608Metric
U6: TD301M485

Connections:
3V3: C31.1, C32.1, D14.1 (K), U6.4 (VCC); also elsewhere on the board
/[04] RS485/RS485_A: J7.3, R32.1
/[04] RS485/RS485_B: J7.2, R34.1
GND: C31.2, C32.2, D14.2 (A), U6.3 (GND); also elsewhere on the board
unnamed: D12.1 (A1), D13.1 (K), R31.2, R32.2, R33.2, U6.6 (B)
unnamed: D12.2 (A2), D13.2 (A), JP4.1 (A), R34.2, R35.1, U6.7 (A)
unnamed: JP4.2 (B), R33.1
RGND: D12.3 (common), J7.1, R31.1, U6.8 (RGND)
RX1_RS485: U6.1 (RXD); also elsewhere on the board
TX1_RS485: U6.2 (TXD); also elsewhere on the board
V_RS485: R35.2, U6.5 (VO)

Notes on the sheet:
RS485

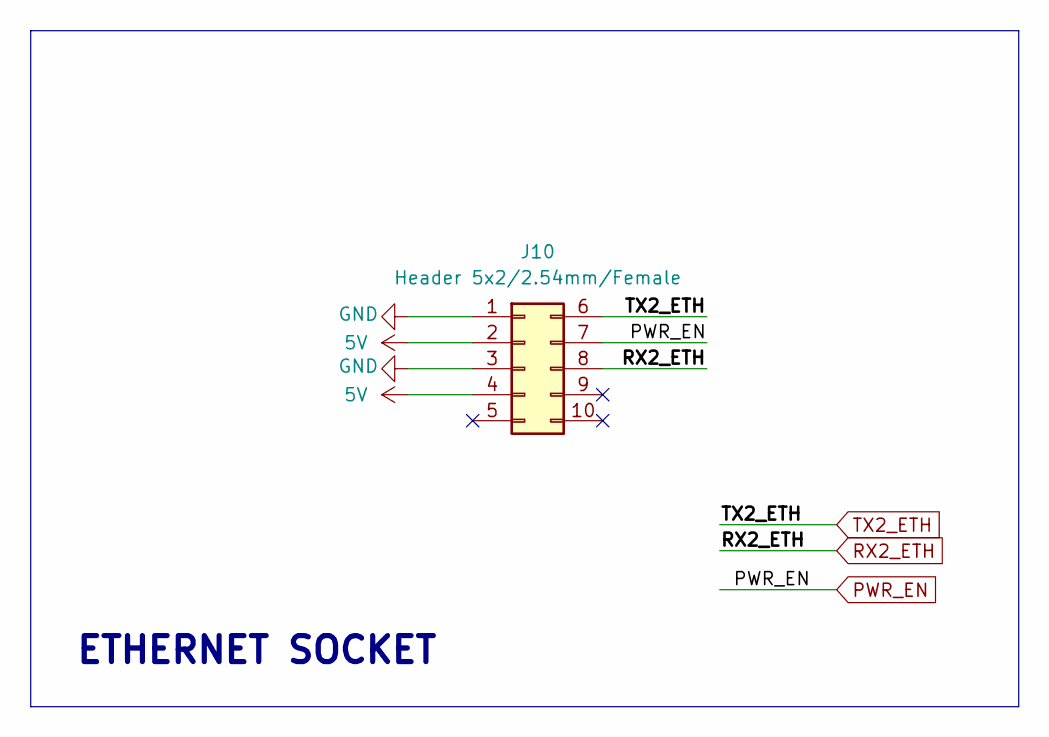
[picture p19: schematic MODULE_ETHERNET.kicad_sch]

Parts:
J10: Header 5x2/2.54mm/Female; PinSocket_2x05_P2.54mm_Vertical

Connections:
5V: J10.2, J10.4; also elsewhere on the board
GND: J10.1, J10.3; also elsewhere on the board
PWR_EN: J10.7; also elsewhere on the board
RX2_ETH: J10.8; also elsewhere on the board
TX2_ETH: J10.6; also elsewhere on the board

Notes on the sheet:
ETHERNET SOCKET

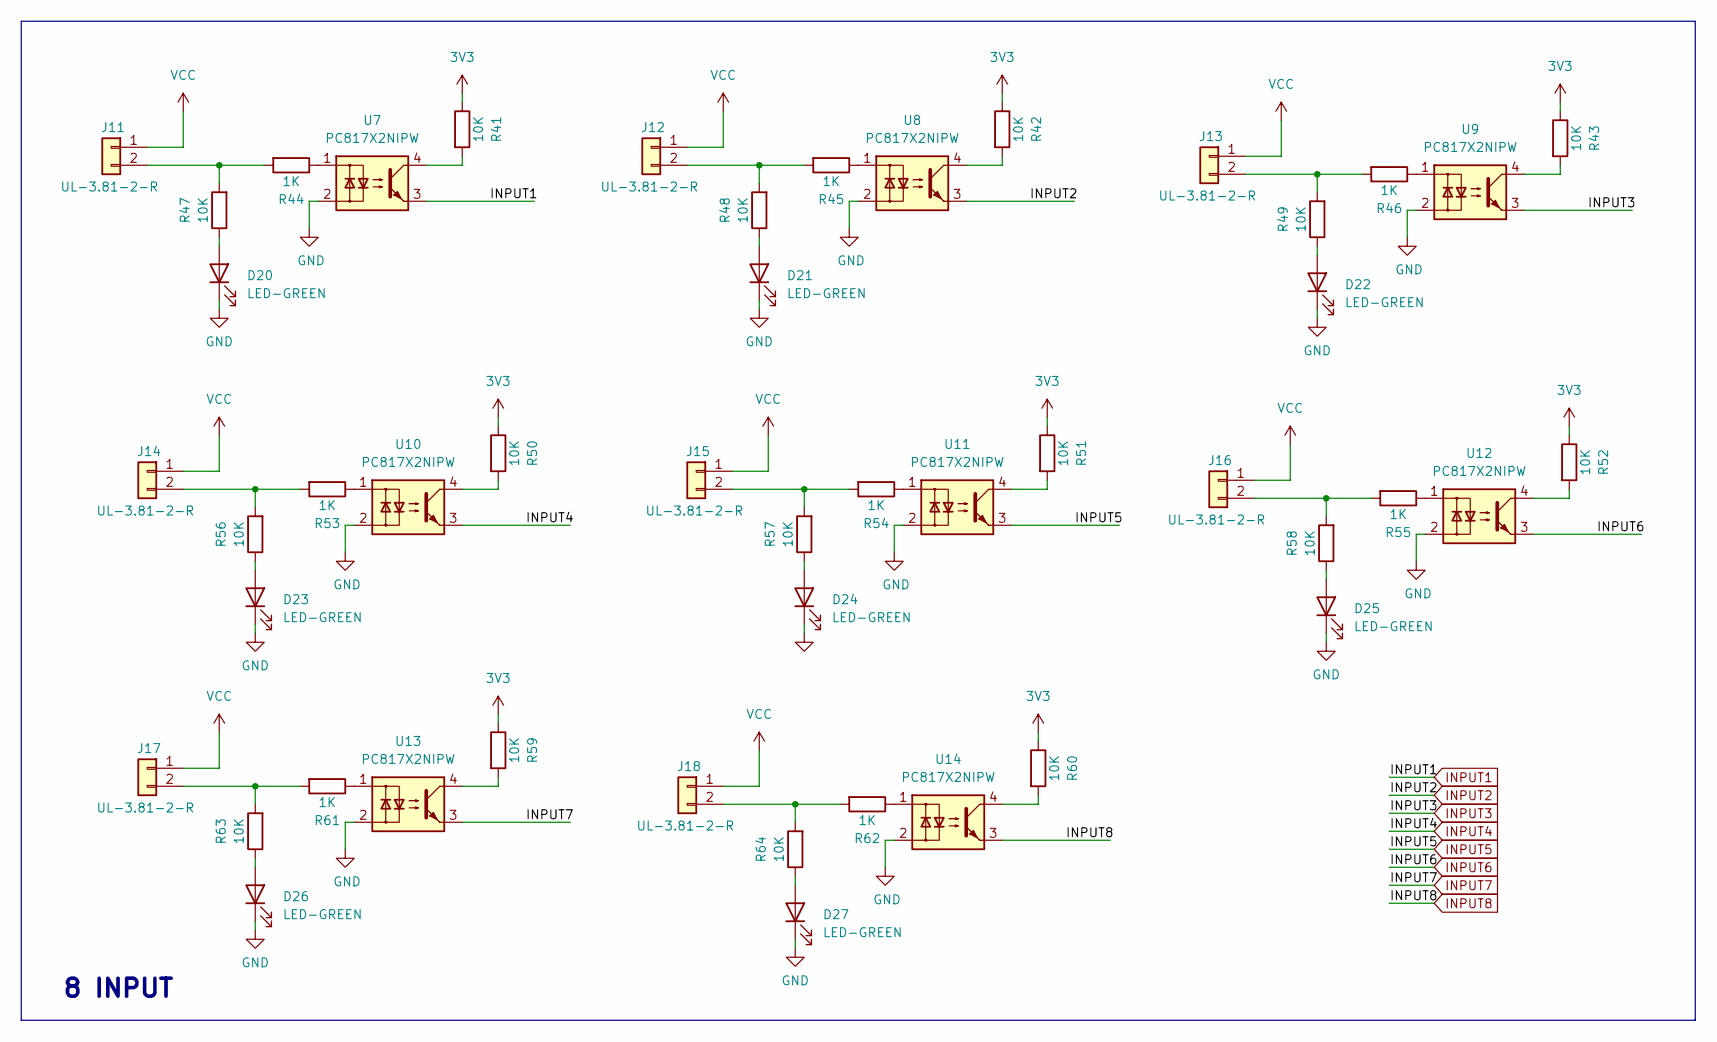
[picture p20: schematic INPUT.kicad_sch]

Parts:
D20, D21, D22, D23, D24, D25, D26, D27: LED-GREEN; LED_0805_2012Metric
J11, J12, J13, J14, J15, J16, J17, J18: UL-3.81-2-R; PhoenixContact_MC_1,5_2-G-3.81_1x02_P3.81mm_Horizontal
R41, R42, R43, R47, R48, R49, R50, R51, R52, R56, R57, R58, R59, R60, R63, R64: 10K; R_0603_1608Metric
R44, R45, R46, R53, R54, R55, R61, R62: 1K; R_0603_1608Metric
U7, U8, U9, U10, U11, U12, U13, U14: PC817X2NIPW; SOP254P960X380-4N

Connections:
3V3: R41.1, R42.1, R43.1, R50.1, R51.1, R52.1, R59.1, R60.1; also elsewhere on the board
GND: D20.1 (K), D21.1 (K), D22.1 (K), D23.1 (K), D24.1 (K), D25.1 (K), D26.1 (K), D27.1 (K), U7.2, U8.2, U9.2, U10.2, U11.2, U12.2, U13.2, U14.2; also elsewhere on the board
INPUT1: U7.3; also elsewhere on the board
INPUT2: U8.3; also elsewhere on the board
INPUT3: U9.3; also elsewhere on the board
INPUT4: U10.3; also elsewhere on the board
INPUT5: U11.3; also elsewhere on the board
INPUT6: U12.3; also elsewhere on the board
INPUT7: U13.3; also elsewhere on the board
INPUT8: U14.3; also elsewhere on the board
unnamed: D20.2 (A), R47.1
unnamed: D21.2 (A), R48.1
unnamed: D22.2 (A), R49.1
unnamed: D23.2 (A), R56.1
unnamed: D24.2 (A), R57.1
unnamed: D25.2 (A), R58.1
unnamed: D26.2 (A), R63.1
unnamed: D27.2 (A), R64.1
unnamed: J11.2, R44.2, R47.2
unnamed: J12.2, R45.2, R48.2
unnamed: J13.2, R46.2, R49.2
unnamed: J14.2, R53.2, R56.2
unnamed: J15.2, R54.2, R57.2
unnamed: J16.2, R55.2, R58.2
unnamed: J17.2, R61.2, R63.2
unnamed: J18.2, R62.2, R64.2
unnamed: R41.2, U7.4
unnamed: R42.2, U8.4
unnamed: R43.2, U9.4
unnamed: R44.1, U7.1
unnamed: R45.1, U8.1
unnamed: R46.1, U9.1
unnamed: R50.2, U10.4
unnamed: R51.2, U11.4
unnamed: R52.2, U12.4
unnamed: R53.1, U10.1
unnamed: R54.1, U11.1
unnamed: R55.1, U12.1
unnamed: R59.2, U13.4
unnamed: R60.2, U14.4
unnamed: R61.1, U13.1
unnamed: R62.1, U14.1
VCC: J11.1, J12.1, J13.1, J14.1, J15.1, J16.1, J17.1, J18.1

Notes on the sheet:
8 INPUT

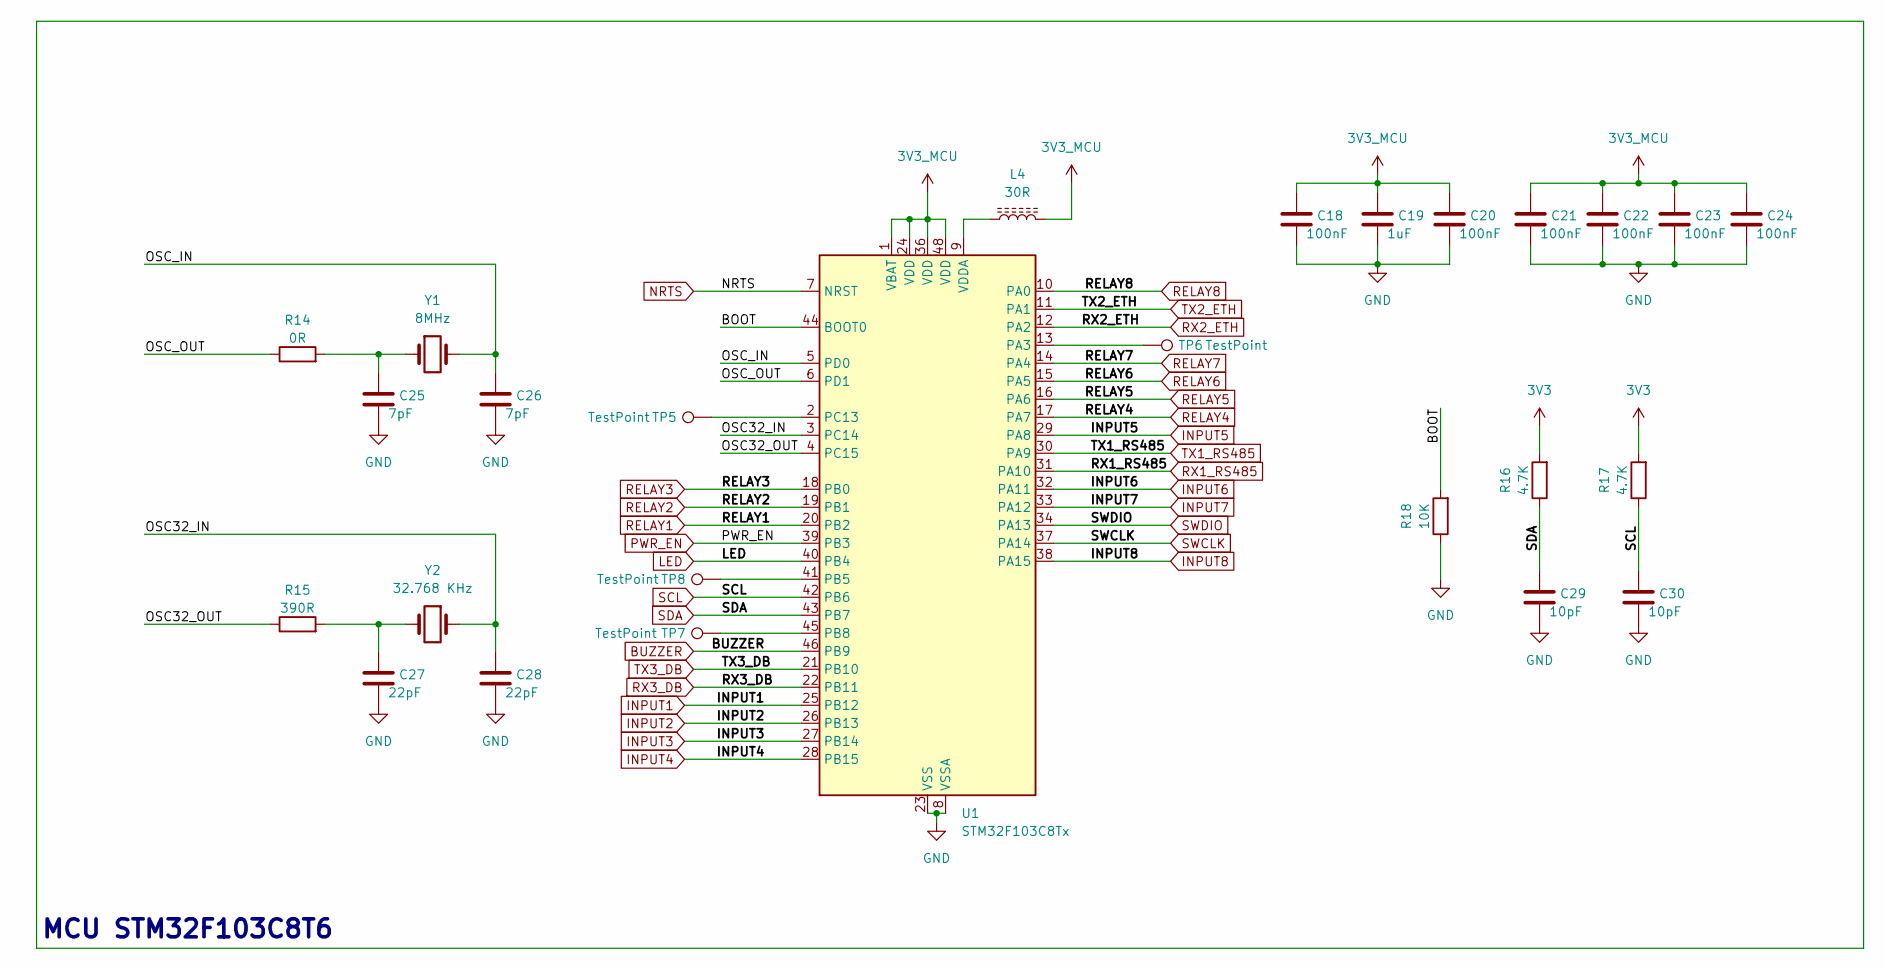
[picture p21: schematic MCU.kicad_sch]

Parts:
C18, C20, C21, C22, C23, C24: 100nF; C_0603_1608Metric
C19: 1uF; C_0603_1608Metric
C25, C26: 7pF; C_0603_1608Metric
C27, C28: 22pF; C_0603_1608Metric
C29, C30: 10pF; C_0603_1608Metric
L4: 30R; L_0805_2012Metric
R14: 0R; R_0603_1608Metric
R15: 390R; R_0603_1608Metric
R16, R17: 4.7K; R_0603_1608Metric
R18: 10K; R_0603_1608Metric
TP5, TP6, TP7, TP8: TestPoint; Pin_D1.3mm_L11.0mm
U1: STM32F103C8Tx; LQFP-48_7x7mm_P0.5mm
Y1: 8MHz; Crystal_HC49-4H_Vertical
Y2: 32.768 KHz; Crystal_C38-LF_D3.0mm_L8.0mm_Horizontal

Connections:
3V3: R16.2, R17.2; also elsewhere on the board
3V3_MCU: C18.1, C19.1, C20.1, C21.1, C22.1, C23.1, C24.1, L4.2, U1.1 (VBAT), U1.24 (VDD), U1.36 (VDD), U1.48 (VDD); also elsewhere on the board
/[02] MCU/BOOT: R18.2, U1.44 (BOOT0)
/[02] MCU/OSC32_IN: C28.1, U1.3 (PC14), Y2.1
/[02] MCU/OSC32_OUT: R15.1, U1.4 (PC15)
/[02] MCU/OSC_IN: C26.1, U1.5 (PD0), Y1.2
/[02] MCU/OSC_OUT: R14.1, U1.6 (PD1)
BUZZER: U1.46 (PB9); also elsewhere on the board
GND: C18.2, C19.2, C20.2, C21.2, C22.2, C23.2, C24.2, C25.2, C26.2, C27.2, C28.2, C29.2, C30.2, R18.1, U1.8 (VSSA), U1.23 (VSS), U1.35 (VSS), U1.47 (VSS); also elsewhere on the board
INPUT1: U1.25 (PB12); also elsewhere on the board
INPUT2: U1.26 (PB13); also elsewhere on the board
INPUT3: U1.27 (PB14); also elsewhere on the board
INPUT4: U1.28 (PB15); also elsewhere on the board
INPUT5: U1.29 (PA8); also elsewhere on the board
INPUT6: U1.32 (PA11); also elsewhere on the board
INPUT7: U1.33 (PA12); also elsewhere on the board
INPUT8: U1.38 (PA15); also elsewhere on the board
LED: U1.40 (PB4); also elsewhere on the board
NRTS: U1.7 (NRST); also elsewhere on the board
unnamed: C25.1, R14.2, Y1.1
unnamed: C27.1, R15.2, Y2.2
unnamed: TP6.1, U1.13 (PA3)
unnamed: TP8.1, U1.41 (PB5)
unnamed: TP7.1, U1.45 (PB8)
unnamed: TP5.1, U1.2 (PC13)
unnamed: L4.1, U1.9 (VDDA)
PWR_EN: U1.39 (PB3); also elsewhere on the board
RELAY1: U1.20 (PB2); also elsewhere on the board
RELAY2: U1.19 (PB1); also elsewhere on the board
RELAY3: U1.18 (PB0); also elsewhere on the board
RELAY4: U1.17 (PA7); also elsewhere on the board
RELAY5: U1.16 (PA6); also elsewhere on the board
RELAY6: U1.15 (PA5); also elsewhere on the board
RELAY7: U1.14 (PA4); also elsewhere on the board
RELAY8: U1.10 (PA0); also elsewhere on the board
RX1_RS485: U1.31 (PA10); also elsewhere on the board
RX2_ETH: U1.12 (PA2); also elsewhere on the board
RX3_DB: U1.22 (PB11); also elsewhere on the board
SCL: C30.1, R17.1, U1.42 (PB6); also elsewhere on the board
SDA: C29.1, R16.1, U1.43 (PB7); also elsewhere on the board
SWCLK: U1.37 (PA14); also elsewhere on the board
SWDIO: U1.34 (PA13); also elsewhere on the board
TX1_RS485: U1.30 (PA9); also elsewhere on the board
TX2_ETH: U1.11 (PA1); also elsewhere on the board
TX3_DB: U1.21 (PB10); also elsewhere on the board

Notes on the sheet:
MCU STM32F103C8T6

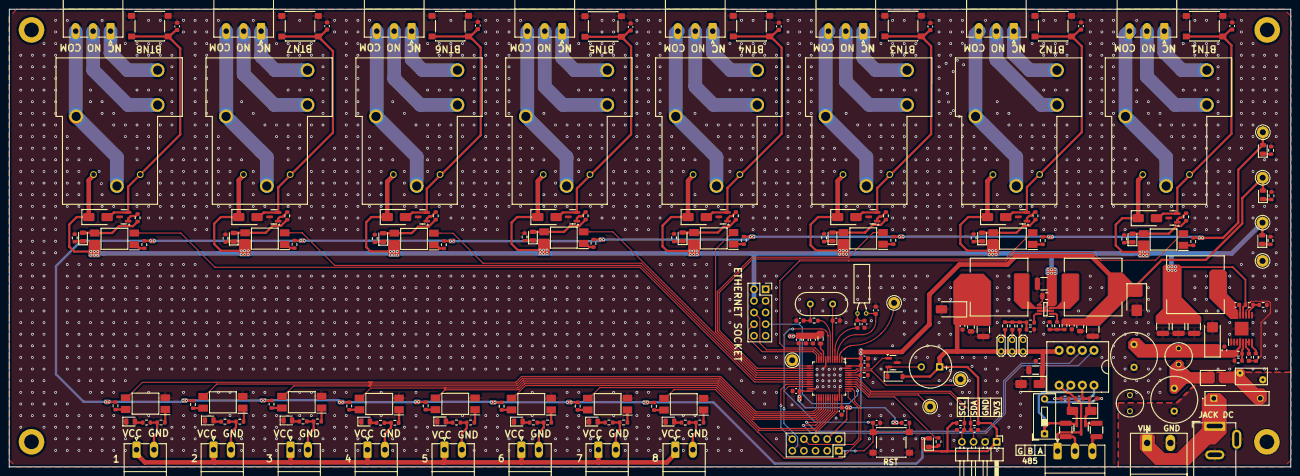
[picture p22: board Module_Relay_RS485.kicad_pcb from above]

Board: 2 copper layers, 280.0 x 100.0 mm, 247 parts (0 on the bottom side), 176 nets.
